psmithul/tensegrity-rover/bom/CY06_Rover_BOM.pdf

CY06 rover bill of materials | 25 October 2026
Supplied BOM total: INR 44,069.06 | 43 procurement lines
ID | Part and specification | Qty | Unit | Unit INR | Line INR | Basis | Supplier
1 | Wheel drive motor Johnson 12 V, 300 rpm | 4 | each | 583.00 | 2,332.00 | Listed | robu.in (https://robu.in/product/grade-a-quality-orange-12v-300-rpm-johnson-geared-dc-motor/)
2 | Servo | 6 | 1,409.00 | 8,454.00 | robu.in (https://robu.in/product/pro-range-ds3225-25kgcm-metal-gear-digital-servo-motor-180-degree/)
3 | Servo motor driver | 6 | 249.00 | 1,494.00 | robu.in (https://robu.in/product/16-channel-12-bit-pwmservo-driver-i2c-interface-pca9685-arduino-raspberry-pi/)
4 | Motor driver
BTS7960 H-bridge, KSTM1859
4 | each | 329.00 | 1,316.00 | Listed | robu.in (https://robu.in/product/double-bts7960-43a-h-bridge-high-power-stepper-motor-driver-module/)
5 | Wheel controller
Raspberry Pi Pico, RP2040
1 | each | 384.00 | 384.00 | Listed | Robu (https://robu.in/product/raspberry-pi-pico/)
6 | Logger and preload controller
Teensy
1 | each | 2,785.00 | 2,785.00 | Listed | robocraze.com (https://robocraze.com/products/teensy-4-0-development-board?variant=42205078192352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)
7 | Vibration accelerometer
ADXL345 module, RDNA-C50
3 | each | 255.00 | 765.00 | Listed | robocraze.com (https://robocraze.com/products/adxl345-digital-angle-acceleration-sensor-module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)
8 | Chassis attitude sensor
MPU6050 module, RDNA-E529
1 | each | 173.00 | 173.00 | Listed | robokits.co.in (https://robokits.co.in/sensors/accelerometer-and-magnetometer/triple-axis-accelerometer-gyro-mpu-6050-breakout)
9 | Encoder circuit set
Comparators, circuit boards and small components
1 | set | 300.00 | 300.00 | Estimate | Not specified
10 | Control signal buffer
74HCT245, 3.3 V to 5 V interface
4 | each | 149.00 | 596.00 | Listed | robu.in (https://robu.in/product/sn74hct245n-texas-instruments-transceiver-74hct245-4-5-v-to-5-5-v-dip-20/)
11 | Digital I/O expander
MCP23017 modules, addresses 0x20 and 0x21
2 | each | 332.00 | 664.00 | Listed | FlyRobo (https://www.flyrobo.in/mcu-2317-mcp23017-expander-serial-i2c-interface-module)
12 | Analog multiplexer
CD74HC4067 module, 16 channels
2 | each | 50.00 | 100.00 | Listed | robu.in (https://robu.in/product/cd74hc4067-high-speed-%25e2%2580%258b%25e2%2580%258bcmos-16-channel-analogdigital-multiplexer-breakout-module/)
13 | Input conditioning circuit set
Thirty ADC inputs, startup pull-downs and interface components
1 | set | 400.00 | 400.00 | Estimate | Not specified
INR. Rates and quantities as supplied. | 1 / 3

Supplied BOM total: INR 44,069.06 | 43 procurement lines
ID | Part and specification | Qty | Unit | Unit INR | Line INR | Basis | Supplier
14 | Preload position sensor Linear Hall sensor module | 6 | each | 40.00 | 240.00 | Listed | robu.in (https://robu.in/product/lm393-linear-hall-effect-sensor-module/)
15 | Preload travel limit switches
KW11 normally closed switches, pack of two
6 | pack | 29.00 | 174.00 | Listed | Robu (https://robu.in/product-category/limit-switch/)
16 | Memory card interface
SPI microSD reader module
1 | each | 40.00 | 40.00 | Listed | FlyRobo (https://www.flyrobo.in/tf-wifi-micro-sd-card-reader-module-for-d1-mini)
17 | Logging memory card
16 GB Class 10 microSD card
1 | each | 499.00 | 499.00 | Listed | HUBTRONICS (https://hubtronics.in/16gb-micro-sd-card)
18 | Battery
Li-Po
2 | each | 1,700.00 | 3,400.00 | Listed | robu.in (https://robu.in/product/orange-11-1v-2500mah-3c-3s-tx-lithium-polymer-battery-pack-with-jst-bec-connector/)
19 | Battery charger
13.8 V, 1.5 A VRLA float charger
1 | each | 249.00 | 249.00 | Listed | MakerBazar (https://makerbazar.in/products/12v-7ah-9ah-lead-acid-battery-charger12v-7ah-9ah-lead-acid-battery-charger)
20 | Motor supply relay
EF40-1A-12V power relay
1 | each | 76.70 | 76.70 | Listed | Rajiv Electronics (https://rajivelectronics.com/product/ef40-1a-12v-automotive-4-pin-40a-12vdc-relay-automotive-power-relay)
21 | Relay connection set
Socket, coil suppression and terminals
1 | set | 70.00 | 70.00 | Estimate | Rajiv Electronics / local assembly (https://rajivelectronics.com/product/ef40-1a-12v-automotive-4-pin-40a-12vdc-relay-automotive-power-relay)
22 | Emergency stop switch
Latching normally closed switch
1 | each | 109.00 | 109.00 | Listed | robu.in (https://robu.in/product/ac-660v-10a-lay37-dpst-emergency-stop-push-button-switch/)
23 | Ring Magnet
K800
1 | each | 29.00 | 29.00 | Listed | robu.in (https://robu.in/product/k800-round-super-circular-magnet/)
24 | Logic power regulator
5 V DC/DC converter
1 | each | 93.00 | 93.00 | Listed | FlyRobo (https://www.flyrobo.in/xl4015-5a-dc-dc-adjustable-step-down-power-supply-module-1)
25 | Sensor power regulator set
3.3 V regulator and decoupling components
1 | set | 50.00 | 50.00 | Estimate | Not specified
26 | Observation camera
ESP32-CAM module
1 | each | 750.00 | 750.00 | Listed | robocraze.com (https://robocraze.com/products/esp32s-cam-wifi-development-board-with-rhyx-m21-45-camera-module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)
27 | Power harness set
Power cable and locking connectors for twelve motor channels
1 | set | 900.00 | 900.00 | Estimate | Robu / local assembly (https://robu.in/product/14awg-silicone-braided-wire-black/)
28 | Signal harness set
Sensor wiring, connectors and integration PCB
1 | set | 700.00 | 700.00 | Estimate | ProBots / local assembly (https://probots.co.in/4-pin-jst-xh-polarised-connector-254mm-wire-harness.html)

Supplied BOM total: INR 44,069.06 | 43 procurement lines
ID | Part and specification | Qty | Unit | Unit INR | Line INR | Basis | Supplier
29 | Lock position switches Normally closed switches, pack of two
3 | pack | 29.00 | 87.00 | Listed | Robu (https://robu.in/product-category/limit-switch/)
30 | Battery energy measurement kit
INA219, external shunt and Kelvin connections
1 | set | 139.00 | 139.00 | Mixed | robu.in (https://robu.in/product/cjmcu-219-ina219-i2c-interface-no-drift-bi-directional-current-power-monitoring-sensor-module/)
31 | Rotary Encoder | 1 | set | 500.00 | 500.00 | robu.in (https://robu.in/product/oe-28-hall-effect-two-channel-magnetic-encoder/)
32 | Aluminium sheet and plate 600 x 600 x 2 mm; 600 x 600 x 4 mm; 200 x 200 x 12 mm
1 | lot | 3,304.00 | 3,304.00 | Estimate | Rajesh Aluminium
| | | | | | India (https://www.rajeshaluminium.com/gujarat)
33 | Aluminium hub bar Diameter 40 mm, length 300 mm
1 | length | 708.00 | 708.00 | Estimate | Rajesh Aluminium
| | | | | | India (https://www.rajeshaluminium.com/gujarat)
34 | Steel and brass stock Shaft rods, sleeve tube and brass nut blanks
1 | lot | 1,534.00 | 1,534.00 | Estimate | Rajesh Aluminium /
| | | | | | local Indian metal stockist (https://www.rajeshaluminium.com/gujarat)
35 | Steel lock and bracket blanks 40 x 20 x 2 mm rectangular tube, 450 mm long
2 | length | 206.50 | 413.00 | Estimate | Manish Steel Center
| | | | | | India (https://www.manishsteels.com/rectangle-pipes.php)
36 | Polymer stock PTFE tube, acetal offcuts and 1.5 mm roof sheet
1 | lot | 1,062.00 | 1,062.00 | Estimate | Robu / polymer
| | | | | | stockist (https://robu.in/product/ptfe-2x4mm-teflon-tubing-for-3d-printers-1-75mm-filament-1m/)
37 | PETG filament 1 kg spool, 1.75 mm diameter
3 | spool | 798.86 | 2,396.58 | Listed | Dream Polymers India (https://dreampolymers.com/product/petg-pro-3d-printing-filament/)
38 | TPU 95A filament
1 kg spool, 1.75 mm diameter
1 | spool | 1,414.82 | 1,414.82 | Listed | 3D Master India (https://3dmasterindia.in/product/isanmate-tpu-flexible-filament-black/)
39 | Tension cable and fittings
Stainless cable, swage sleeves and termination stock
1 | lot | 944.00 | 944.00 | Estimate | EBMP India (https://www.ebmpindia.com/steel-wire-ropes.html)
40 | Radial bearing
NBC 6001ZZ, 12 x 28 x 8 mm
24 | each | 21.00 | 504.00 | Listed | omrook.com (https://omrook.com/6001-2rs-deep-groove-ball-bearing-12x28x8/)
41 | Preload thrust bearing
NTN 51100, 10 x 24 x 9 mm
6 | each | 102.66 | 615.96 | Listed | omrook.com (https://omrook.com/51100-thrust-ball-bearing-id-10mm-od-24mm-th-9mm/)
42 | Fasteners and inserts
Bulk M2-M6 screws, nuts, inserts and retaining fittings
1 | lot | 2,832.00 | 2,832.00 | Estimate | Local fastener stockist (https://in.misumi-ec.com/vona2/detail/221000551286/)
43 | Assembly consumables
Rigid epoxy, protective pads, lubricant and cleaner
1 | lot | 472.00 | 472.00 | Mixed | Joy Guru Hardware (https://www.joyguruhardware.com/product/32365749/Araldite-Epoxy-Adhesive-90-gm)
