psmithul/tensegrity-rover/models/Print_Blanks/Fixed_Star_Plate_Print_Blank_Left.step

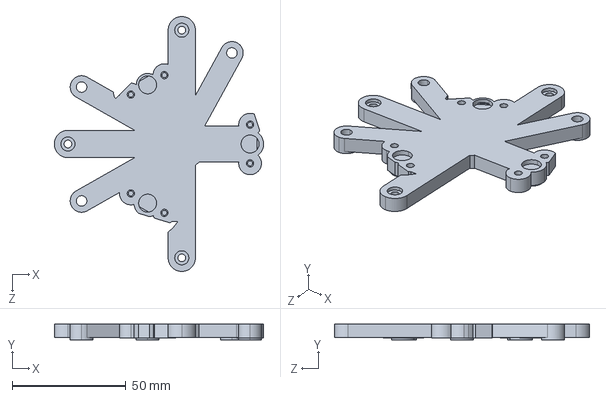
[picture p17: CAD file, 2026-11-02]
models/Print_Blanks/Fixed_Star_Plate_Print_Blank_Left.step
92.0 x 7.00 x 112.0 mm
