psmithul/tensegrity-rover/models/SolidWorks/References/Joint_Preload_Hardware_References.SLDPRT

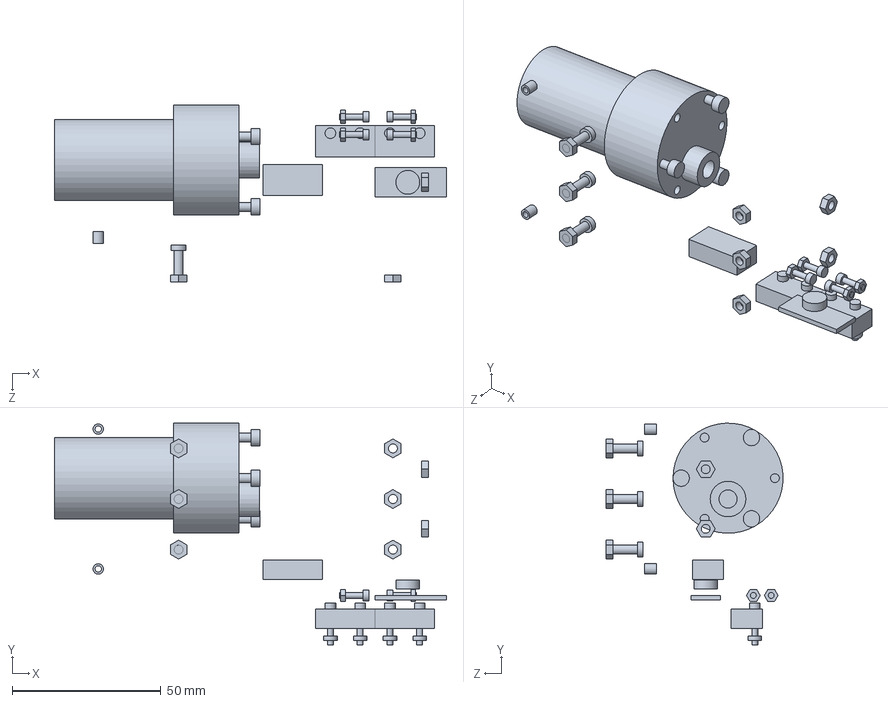
[picture p18: CAD file, 2026-11-02]
models/SolidWorks/References/Joint_Preload_Hardware_References.SLDPRT
131.7 x 74.5 x 59.5 mm
