psmithul/tensegrity-rover/models/STEP/Fixed_Frame.step

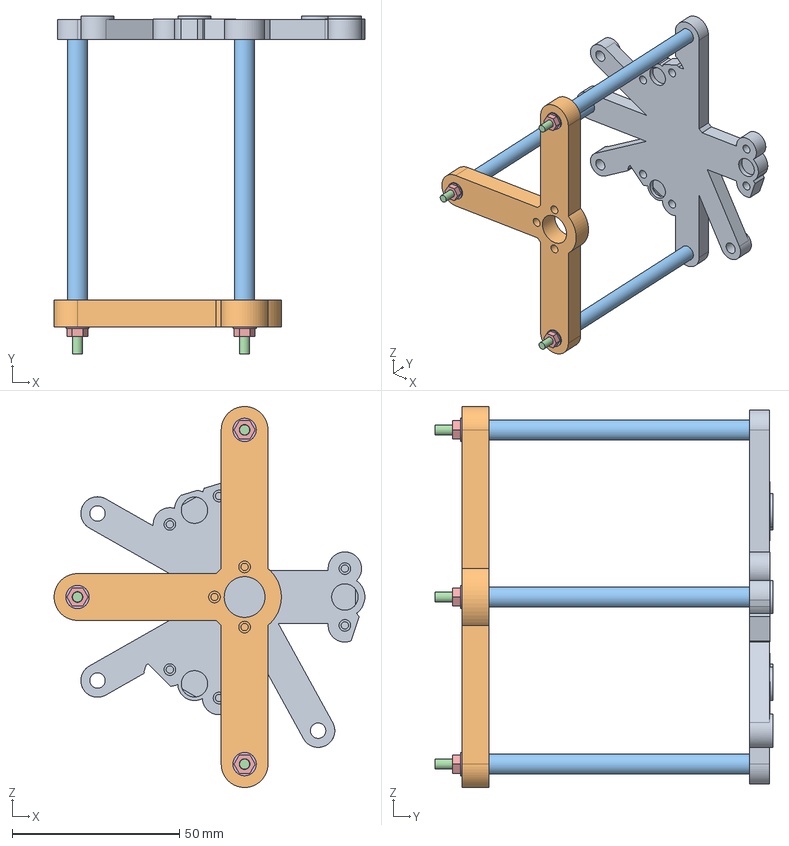
[picture p19: CAD file, 2026-11-02]
models/STEP/Fixed_Frame.step
93.0 x 101.1 x 114.0 mm
