psmithul/tensegrity-rover/models/STEP/Parts/Preload_Guide_Rod_End_Stop.step

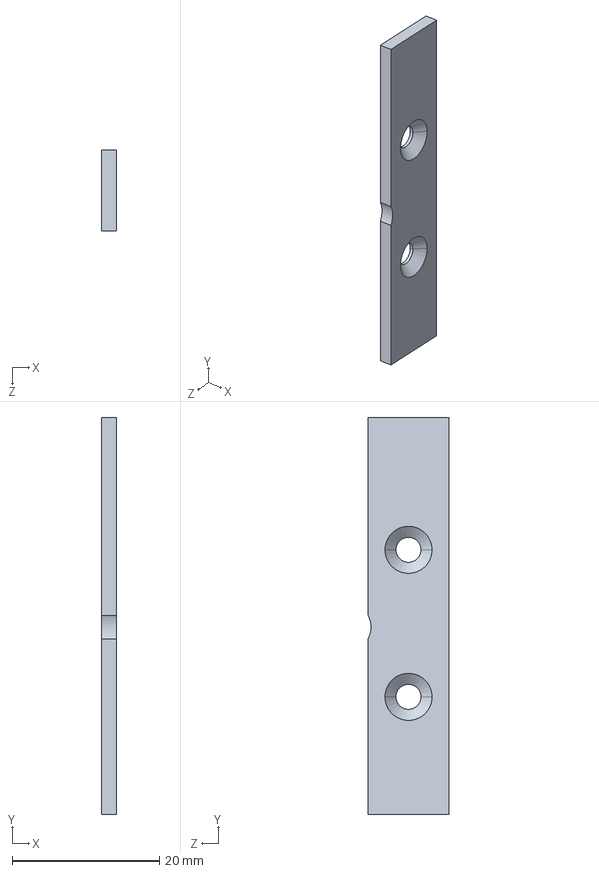
[picture p20: CAD file, 2026-11-02]
models/STEP/Parts/Preload_Guide_Rod_End_Stop.step
2.00 x 54.0 x 11.0 mm
