psmithul/tensegrity-rover/models/STEP/Purchased_Components/Rover_Vibration_Sensors_References.step

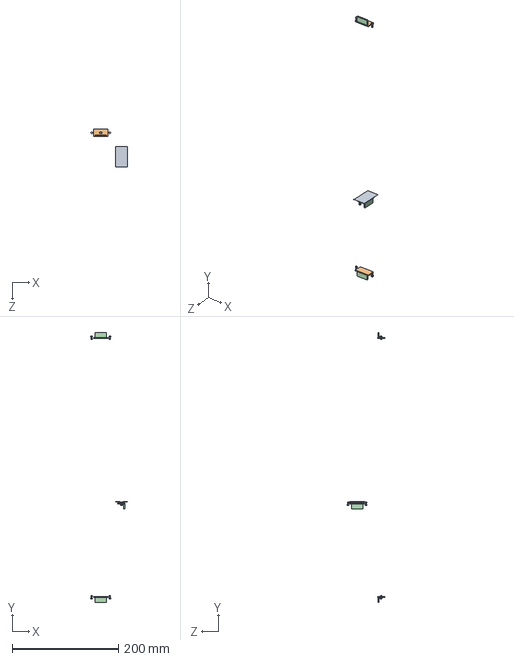
[picture p21: CAD file, 2026-11-02]
models/STEP/Purchased_Components/Rover_Vibration_Sensors_References.step
68.9 x 508.0 x 71.2 mm
