psmithul/tensegrity-rover/models/Print_Blanks/Rear_Support_Plate_Print_Blank.step

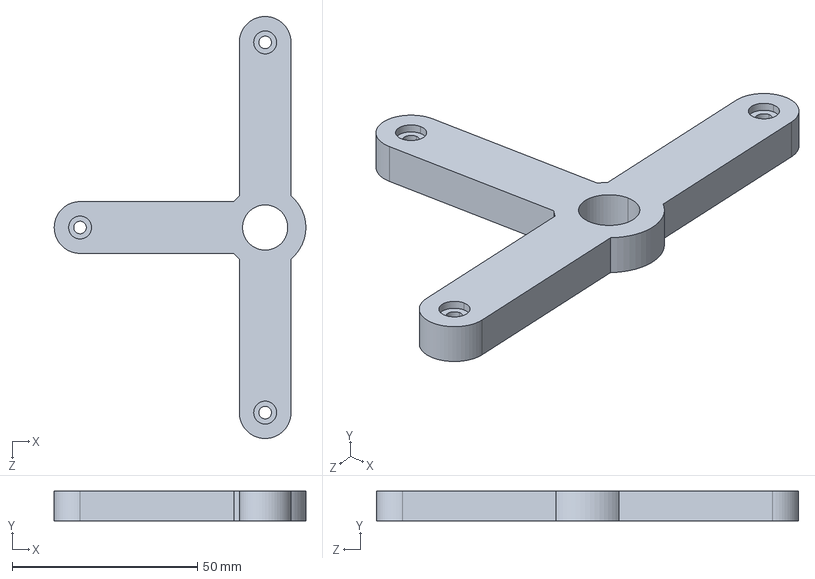
[picture p22: CAD file, 2026-11-02]
models/Print_Blanks/Rear_Support_Plate_Print_Blank.step
68.0 x 8.00 x 114.0 mm
