psmithul/tensegrity-rover/models/STEP/Parts/Suspension_Compression_Link_3_Moving_Ball_Retainer_Left.step

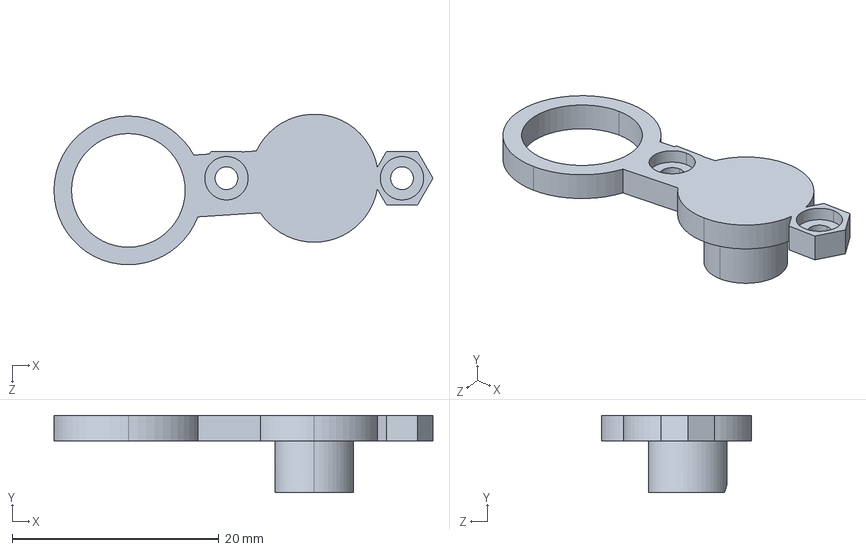
[picture p23: CAD file, 2026-11-02]
models/STEP/Parts/Suspension_Compression_Link_3_Moving_Ball_Retainer_Left.step
36.7 x 7.50 x 14.6 mm
