psmithul/tensegrity-rover/models/STEP/Purchased_Components/Rover_Rear_Left_Suspension_References.step

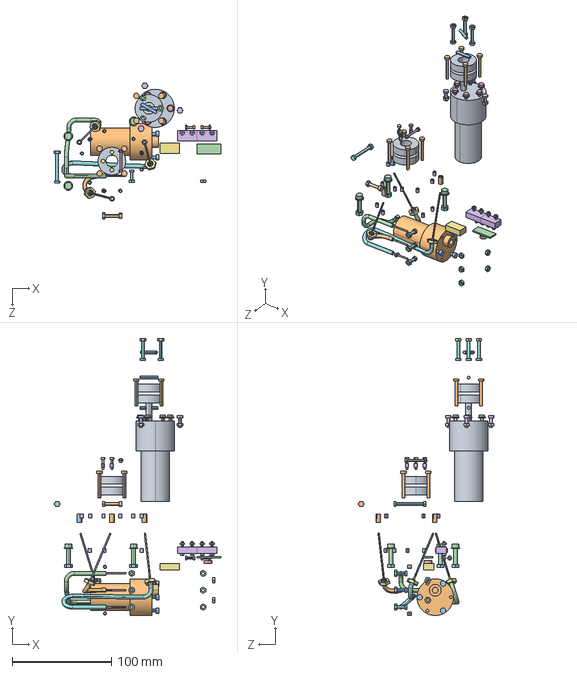
[picture p24: CAD file, 2026-11-02]
models/STEP/Purchased_Components/Rover_Rear_Left_Suspension_References.step
168.4 x 279.5 x 137.1 mm
