psmithul/tensegrity-rover/models/STEP/Parts/Suspension_Fixed_Steel_Cup_Liner_2.step

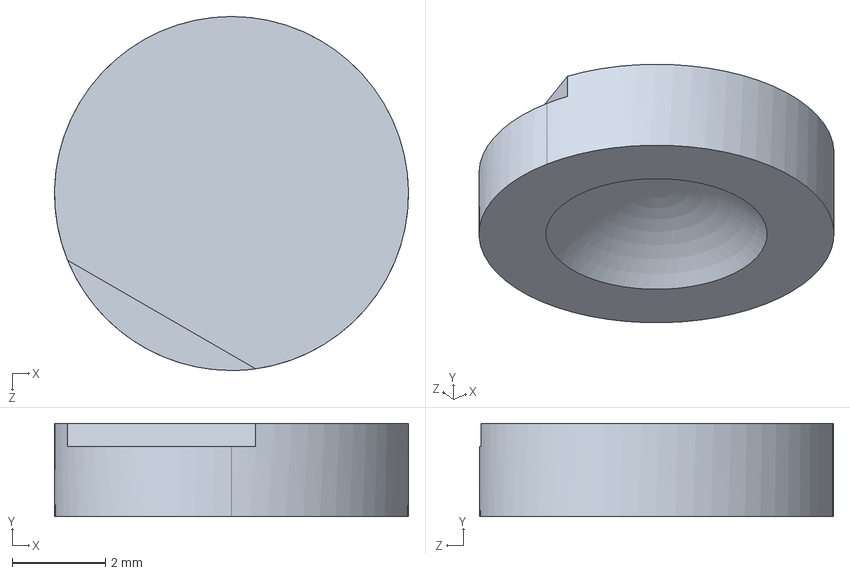
[picture p25: CAD file, 2026-11-02]
models/STEP/Parts/Suspension_Fixed_Steel_Cup_Liner_2.step
7.60 x 2.00 x 7.60 mm
