psmithul/tensegrity-rover/models/STEP/Purchased_Components/Rover_Middle_Right_Suspension_References.step

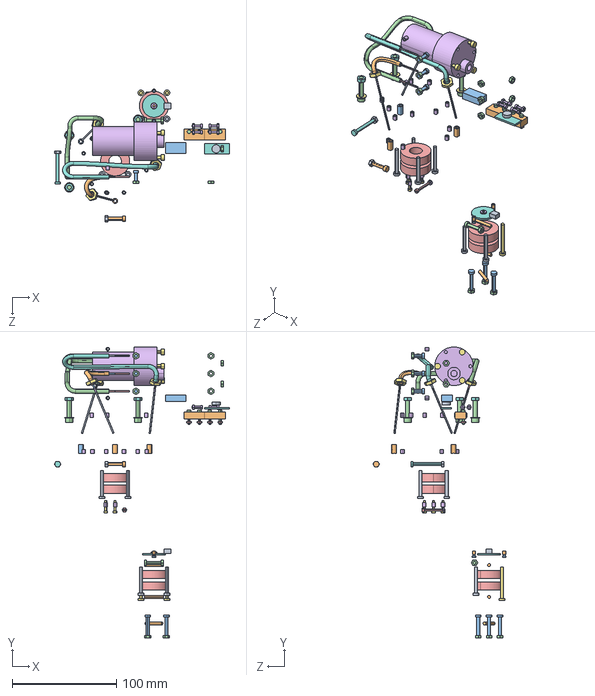
[picture p26: CAD file, 2026-11-02]
models/STEP/Purchased_Components/Rover_Middle_Right_Suspension_References.step
168.4 x 279.5 x 127.9 mm
