psmithul/tensegrity-rover/models/SolidWorks/References/Joint_Sensor_References.SLDPRT

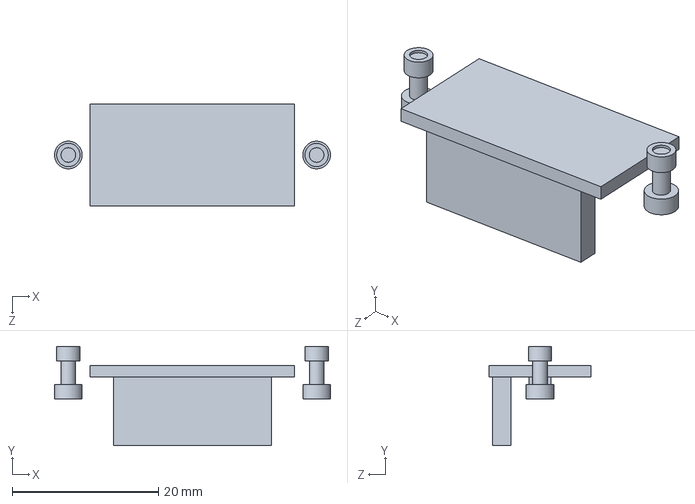
[picture p27: CAD file, 2026-11-02]
models/SolidWorks/References/Joint_Sensor_References.SLDPRT
37.8 x 13.6 x 14.0 mm
