psmithul/tensegrity-rover/models/STEP/Parts/Suspension_Cable_End_Ball_Socket_Left.step

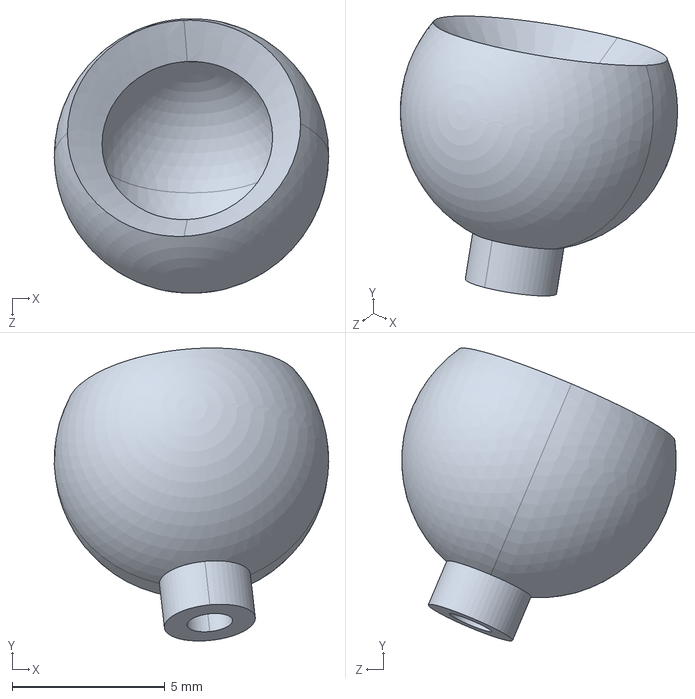
[picture p28: CAD file, 2026-11-02]
models/STEP/Parts/Suspension_Cable_End_Ball_Socket_Left.step
9.00 x 9.60 x 8.99 mm
