psmithul/tensegrity-rover/models/STEP/Purchased_Components/Joint_Joint_Hardware_References.step

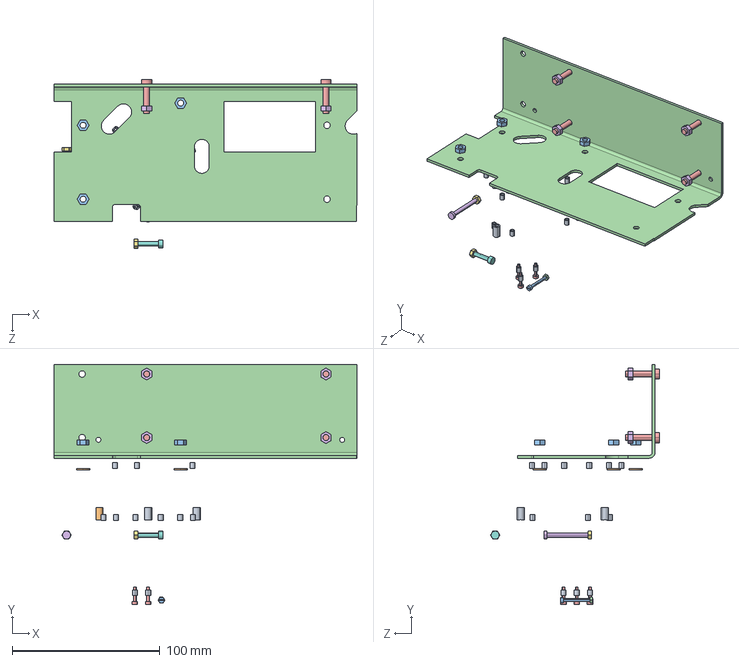
[picture p29: CAD file, 2026-11-02]
models/STEP/Purchased_Components/Joint_Joint_Hardware_References.step
205.0 x 162.5 x 114.4 mm
