psmithul/tensegrity-rover/models/SolidWorks/References/Joint_Wheel_and_Encoder_References.SLDPRT

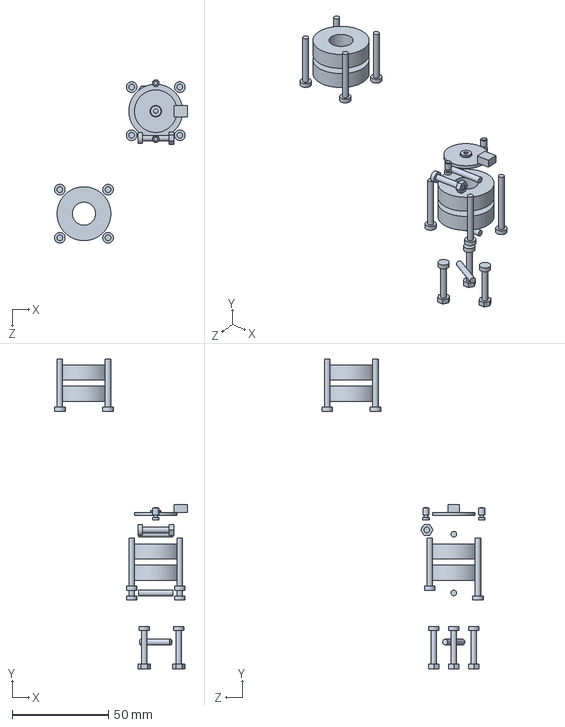
[picture p30: CAD file, 2026-11-02]
models/SolidWorks/References/Joint_Wheel_and_Encoder_References.SLDPRT
69.1 x 161.0 x 84.9 mm
