psmithul/tensegrity-rover/models/STEP/Parts/Suspension_Cable_Support_Mounting_Spacer.step

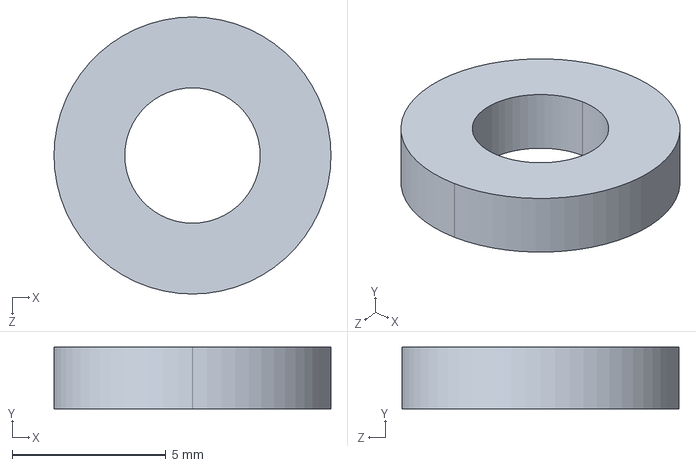
[picture p31: CAD file, 2026-11-02]
models/STEP/Parts/Suspension_Cable_Support_Mounting_Spacer.step
9.00 x 2.00 x 9.00 mm
