psmithul/tensegrity-rover/models/STEP/Parts/Compression_Link_Torque_Pin.step

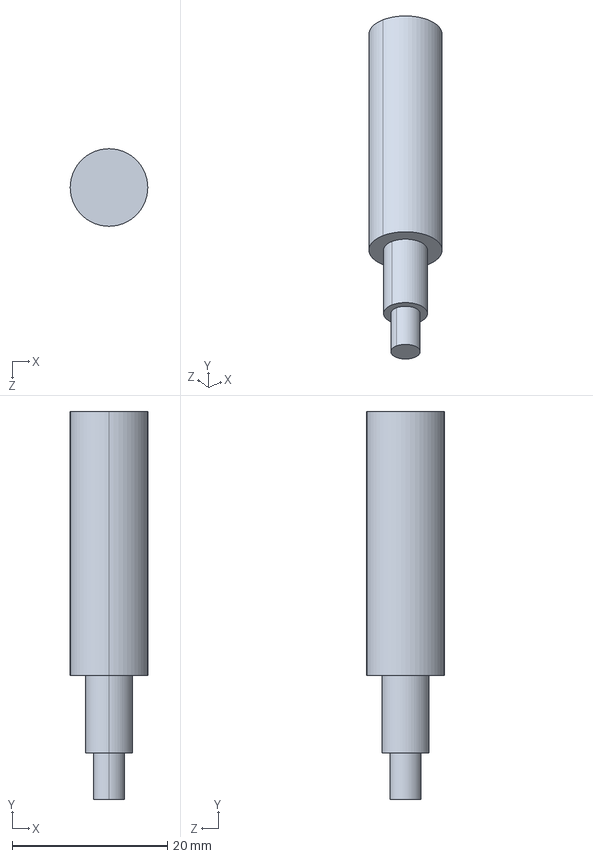
[picture p32: CAD file, 2026-11-02]
models/STEP/Parts/Compression_Link_Torque_Pin.step
10.0 x 50.0 x 10.0 mm
