psmithul/tensegrity-rover/models/STEP/Purchased_Components/Joint_Tension_Network_References.step

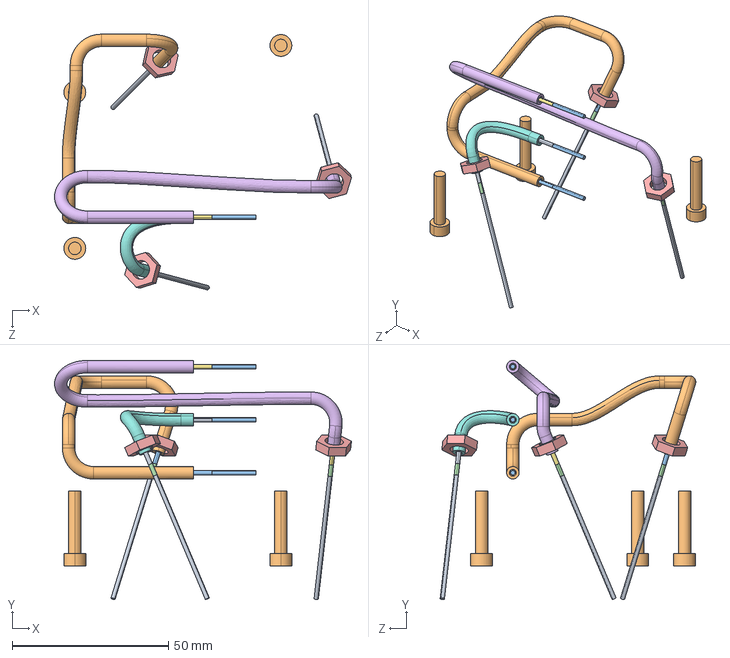
[picture p33: CAD file, 2026-11-02]
models/STEP/Purchased_Components/Joint_Tension_Network_References.step
95.1 x 76.6 x 81.9 mm
