psmithul/tensegrity-rover/models/STEP/Parts/Sensors_Chassis_Accelerometer_Mount.step

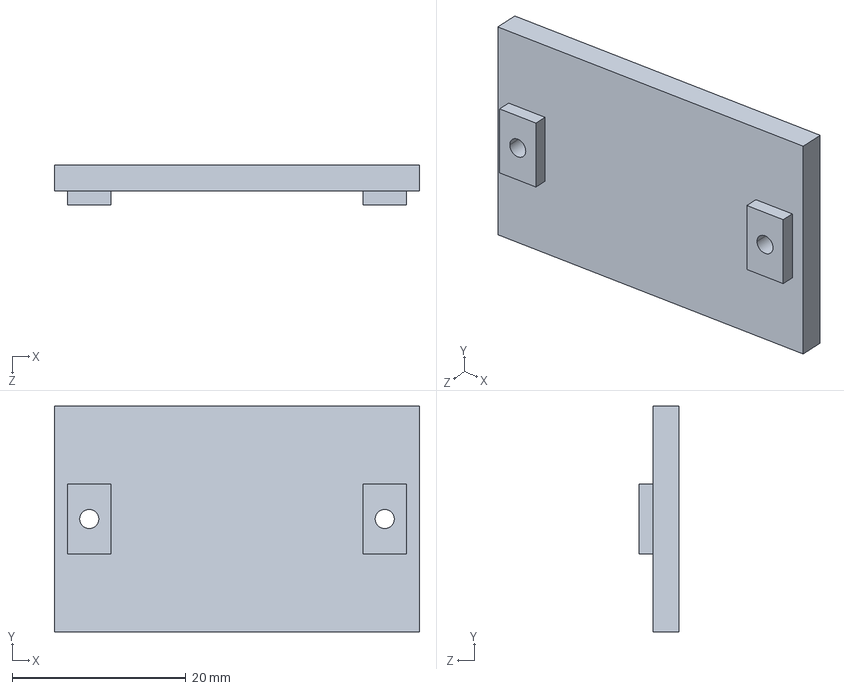
[picture p34: CAD file, 2026-11-02]
models/STEP/Parts/Sensors_Chassis_Accelerometer_Mount.step
42.0 x 26.0 x 4.60 mm
