psmithul/tensegrity-rover/models/SolidWorks/References/Rover_Chassis_and_Electronics_References.SLDPRT

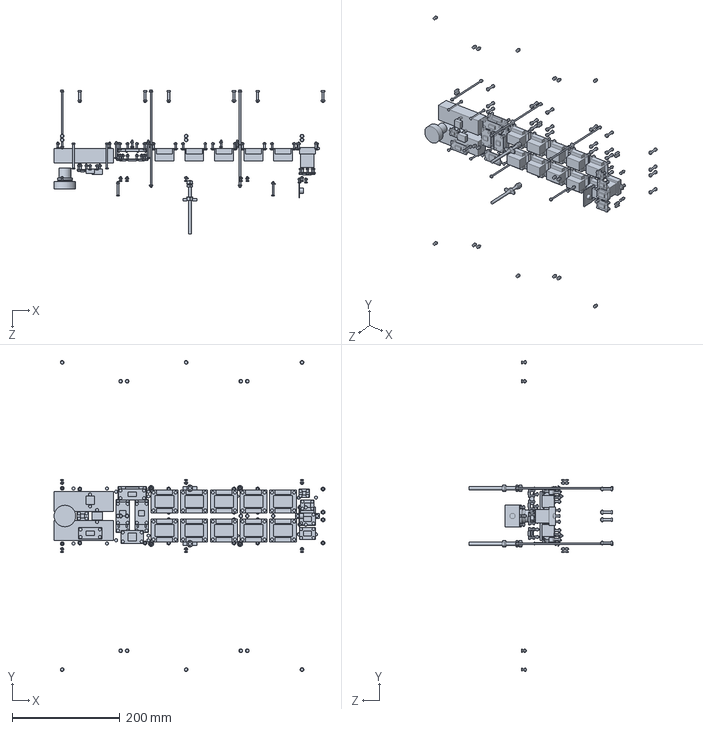
[picture p35: CAD file, 2026-11-02]
models/SolidWorks/References/Rover_Chassis_and_Electronics_References.SLDPRT
502.5 x 577.0 x 268.0 mm
