psmithul/tensegrity-rover/models/STEP/Parts/Chassis_Roof_Support_Arm_1_Right.step

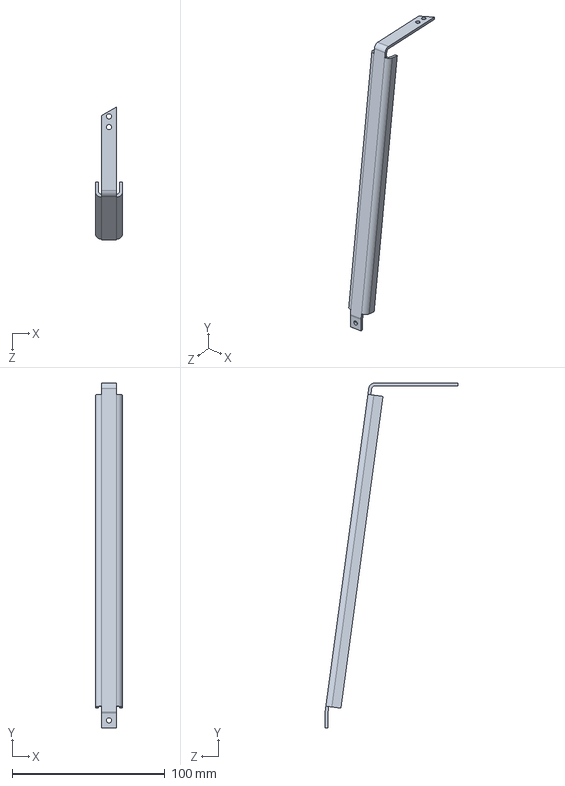
[picture p36: CAD file, 2026-11-02]
models/STEP/Parts/Chassis_Roof_Support_Arm_1_Right.step
18.0 x 226.0 x 87.2 mm
