psmithul/tensegrity-rover/models/SolidWorks/References/Rover_Middle_Left_Suspension_References.SLDPRT

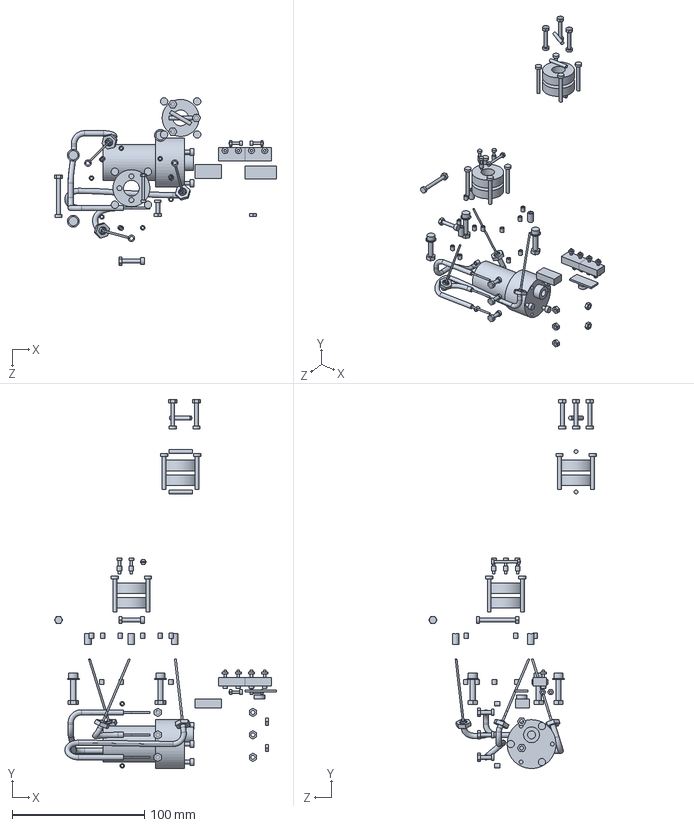
[picture p37: CAD file, 2026-11-02]
models/SolidWorks/References/Rover_Middle_Left_Suspension_References.SLDPRT
168.4 x 279.5 x 126.9 mm
