psmithul/tensegrity-rover/models/STEP/Parts/Drive_Bearing_Cartridge_Left.step

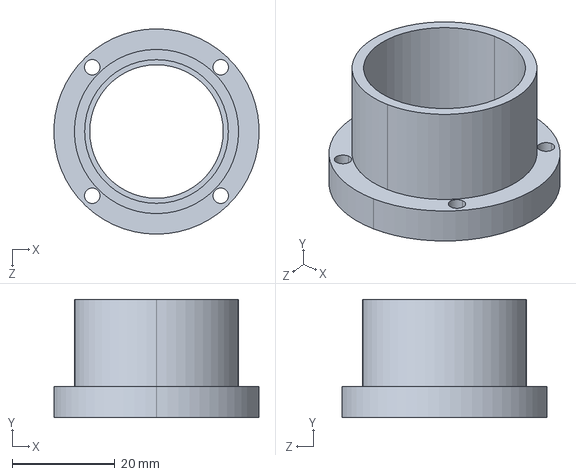
[picture p38: CAD file, 2026-11-02]
models/STEP/Parts/Drive_Bearing_Cartridge_Left.step
39.9 x 23.0 x 40.0 mm
