psmithul/tensegrity-rover/models/STEP/Purchased_Components/Joint_Preload_Hardware_References.step

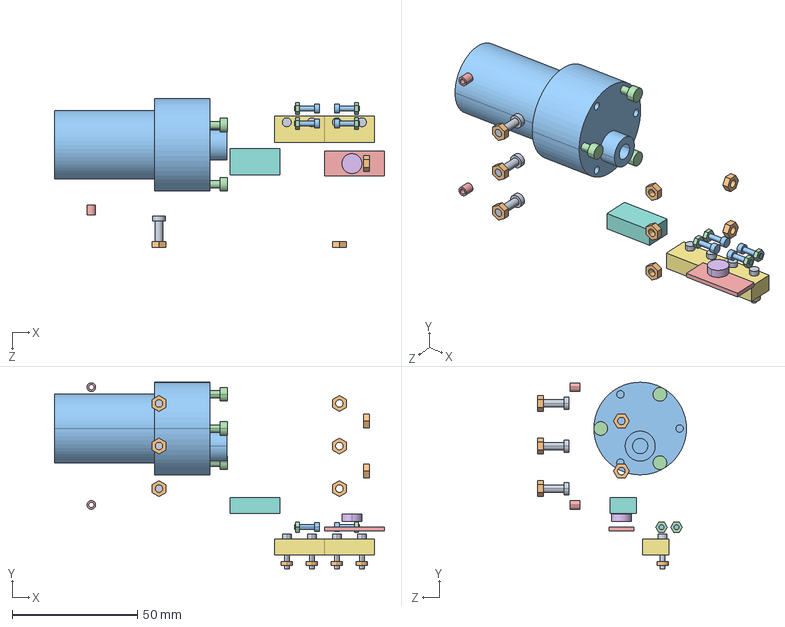
[picture p39: CAD file, 2026-11-02]
models/STEP/Purchased_Components/Joint_Preload_Hardware_References.step
131.7 x 74.5 x 59.5 mm
