psmithul/tensegrity-rover/models/STEP/Parts/Chassis_Platform_Joint_Strap_1_Right.step

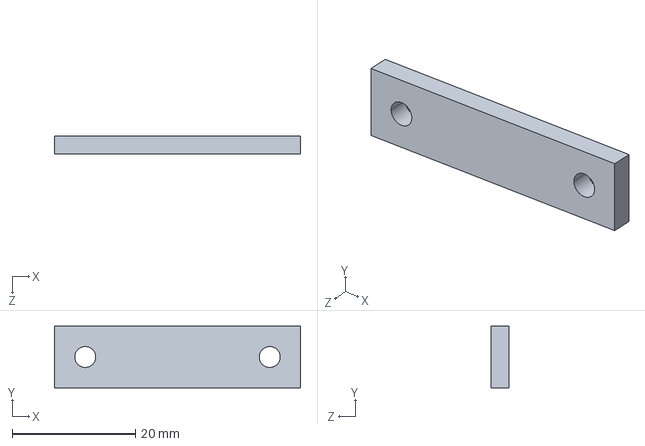
[picture p40: CAD file, 2026-11-02]
models/STEP/Parts/Chassis_Platform_Joint_Strap_1_Right.step
40.0 x 10.0 x 3.00 mm
