psmithul/tensegrity-rover/models/STEP/Parts/Suspension_Acetal_Torque_Guide_Bush_Relieved_Left.step

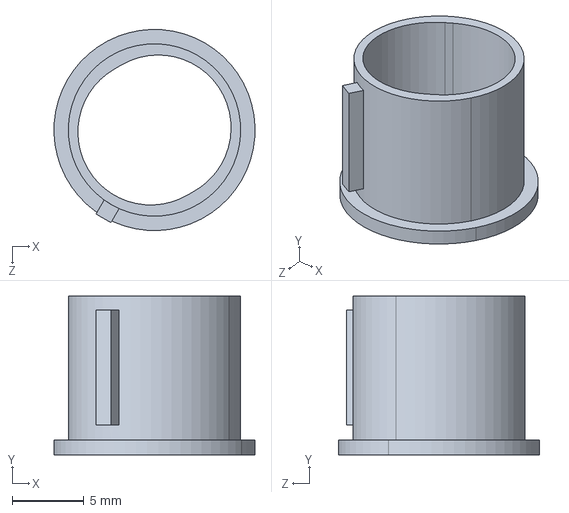
[picture p41: CAD file, 2026-11-02]
models/STEP/Parts/Suspension_Acetal_Torque_Guide_Bush_Relieved_Left.step
14.0 x 11.0 x 14.0 mm
