psmithul/tensegrity-rover/models/STEP/Parts/Chassis_Ballast_End_Stop_Rear.step

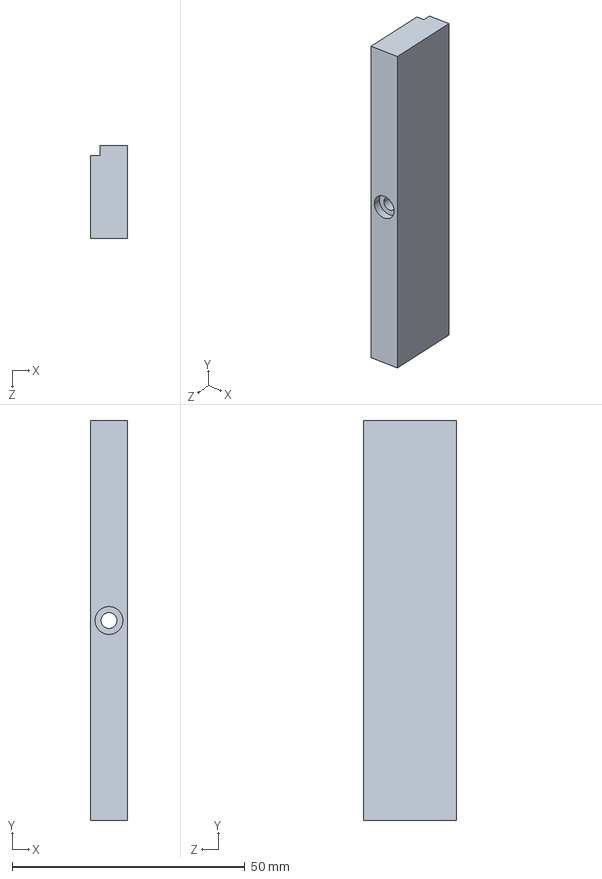
[picture p42: CAD file, 2026-11-02]
models/STEP/Parts/Chassis_Ballast_End_Stop_Rear.step
8.00 x 86.0 x 20.0 mm
