psmithul/tensegrity-rover/models/STEP/Parts/Suspension_Compression_Link_2_Moving_Ball_Retainer.step

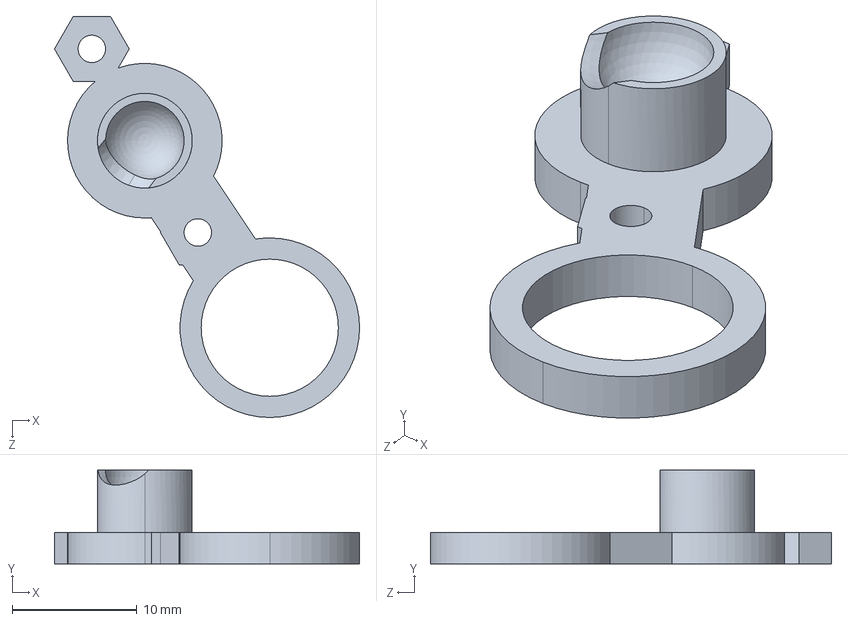
[picture p43: CAD file, 2026-11-02]
models/STEP/Parts/Suspension_Compression_Link_2_Moving_Ball_Retainer.step
24.5 x 7.50 x 32.2 mm
