psmithul/tensegrity-rover/models/STEP/Parts/Drive_Printed_Wheel_Rim_Left.step

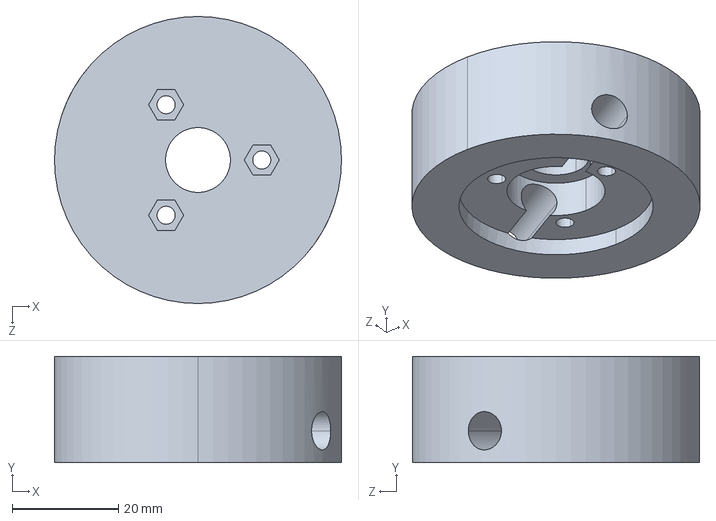
[picture p44: CAD file, 2026-11-02]
models/STEP/Parts/Drive_Printed_Wheel_Rim_Left.step
54.0 x 20.0 x 54.0 mm
