psmithul/tensegrity-rover/models/STEP/Parts/Suspension_Front_Cable_Clevis.step

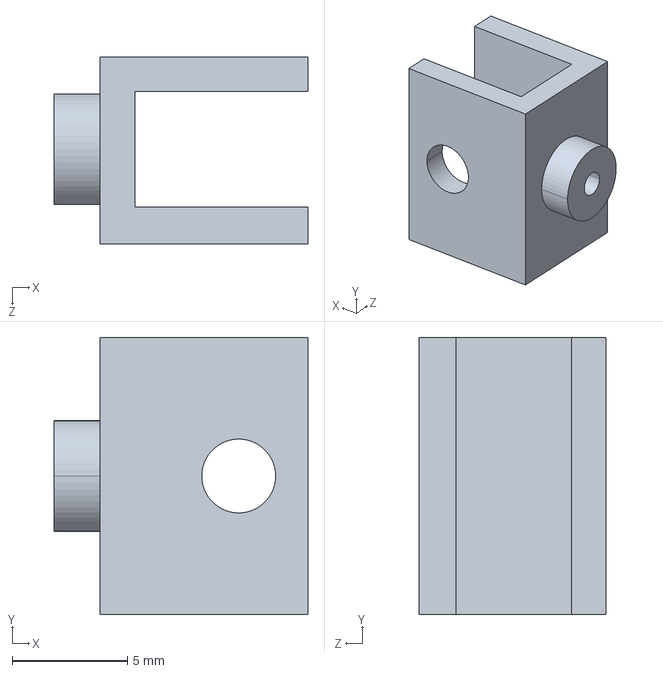
[picture p45: CAD file, 2026-11-02]
models/STEP/Parts/Suspension_Front_Cable_Clevis.step
11.0 x 12.0 x 8.10 mm
