psmithul/tensegrity-rover/models/STEP/Parts/Suspension_Cable_Anchor_Ball_Stud_Left.step

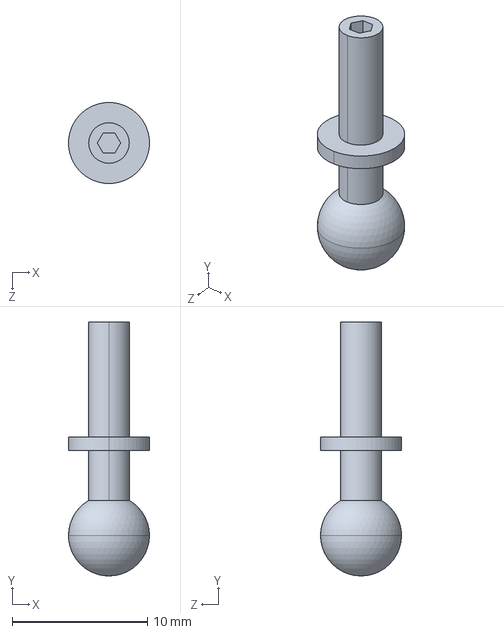
[picture p46: CAD file, 2026-11-02]
models/STEP/Parts/Suspension_Cable_Anchor_Ball_Stud_Left.step
6.00 x 18.8 x 6.00 mm
