psmithul/tensegrity-rover/models/STEP/Parts/Chassis_I2C_Interface_Shelf.step

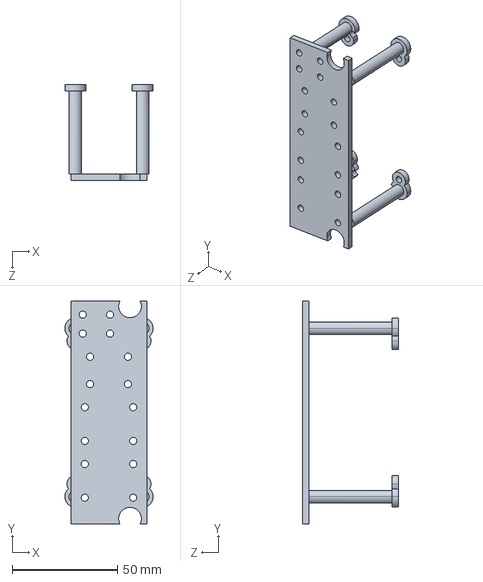
[picture p47: CAD file, 2026-11-02]
models/STEP/Parts/Chassis_I2C_Interface_Shelf.step
42.0 x 106.0 x 45.5 mm
