psmithul/tensegrity-rover/models/STEP/Parts/Suspension_Pivot_Shaft_Split_Clamp_Collar_Left.step

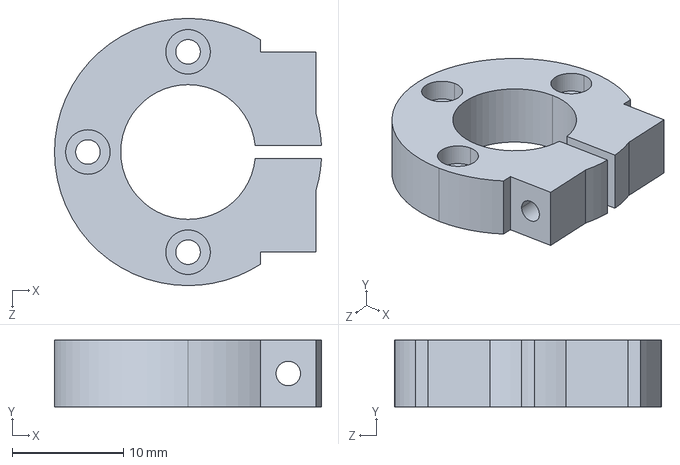
[picture p48: CAD file, 2026-11-02]
models/STEP/Parts/Suspension_Pivot_Shaft_Split_Clamp_Collar_Left.step
24.0 x 6.00 x 24.0 mm
