psmithul/tensegrity-rover/models/STEP/Parts/Preload_Elastomer_Spring_Installed_Envelope.step

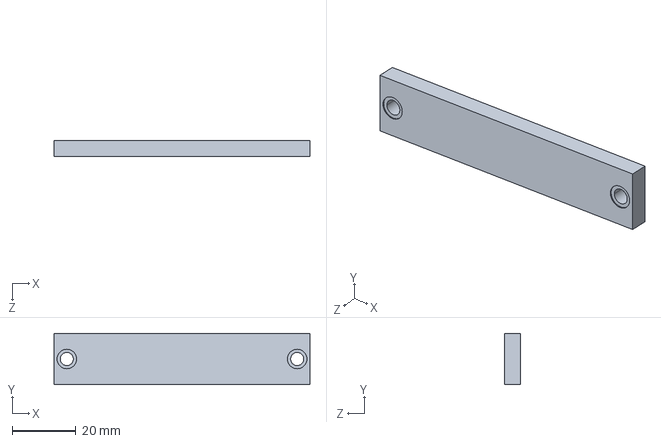
[picture p49: CAD file, 2026-11-02]
models/STEP/Parts/Preload_Elastomer_Spring_Installed_Envelope.step
80.0 x 16.0 x 5.00 mm
