psmithul/tensegrity-rover/models/STEP/Parts/Suspension_Compression_Outer_Sleeve_Left.step

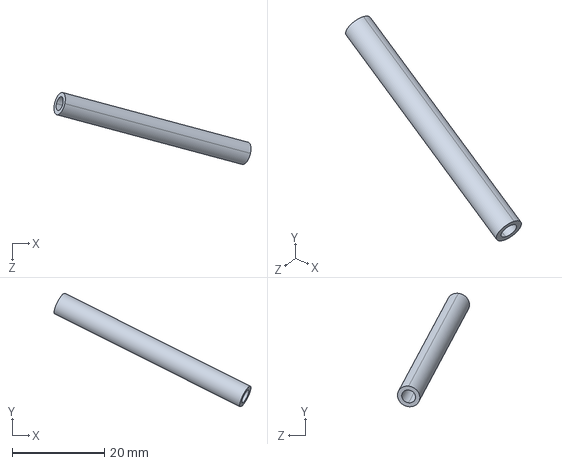
[picture p50: CAD file, 2026-11-02]
models/STEP/Parts/Suspension_Compression_Outer_Sleeve_Left.step
42.8 x 24.7 x 15.7 mm
