psmithul/tensegrity-rover/models/STEP/Parts/Drive_Passive_Wheel_Axle_Left.step

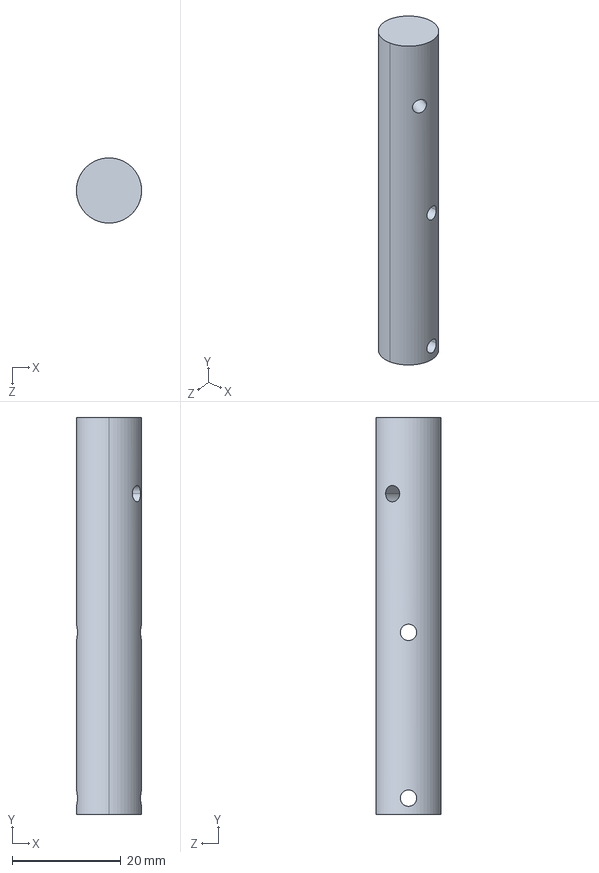
[picture p51: CAD file, 2026-11-02]
models/STEP/Parts/Drive_Passive_Wheel_Axle_Left.step
12.0 x 73.0 x 12.0 mm
