psmithul/tensegrity-rover/models/STEP/Parts/Moving_Tensegrity_Frame.step

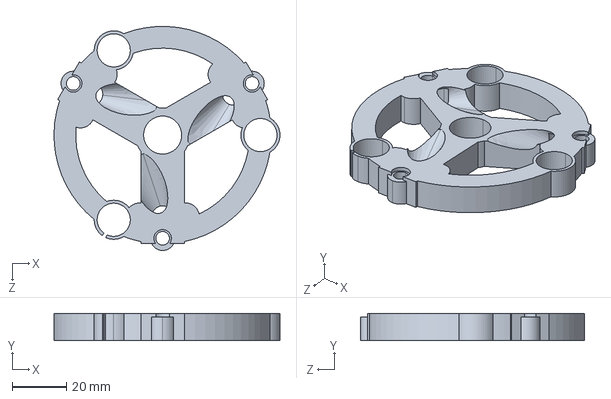
[picture p52: CAD file, 2026-11-02]
models/STEP/Parts/Moving_Tensegrity_Frame.step
83.2 x 10.0 x 82.5 mm
