psmithul/tensegrity-rover/models/STEP/Parts/Drive_Removable_Drive_Motor_Guard.step

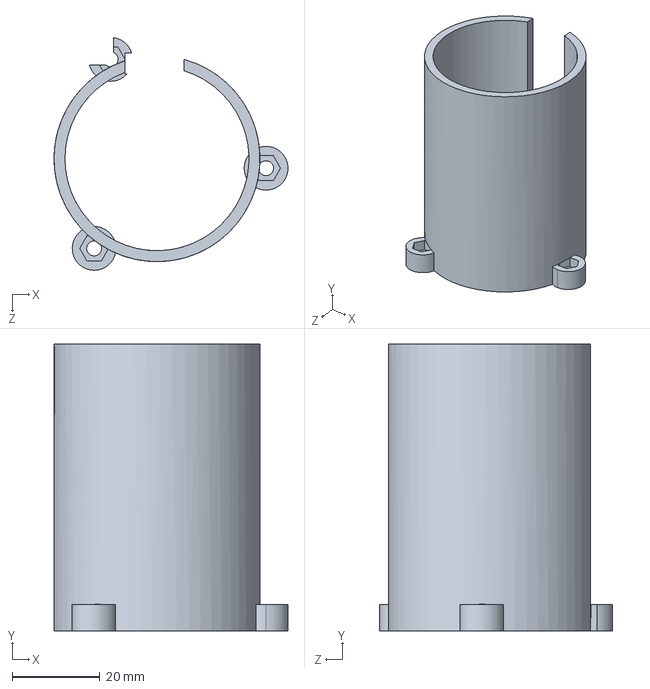
[picture p53: CAD file, 2026-11-02]
models/STEP/Parts/Drive_Removable_Drive_Motor_Guard.step
53.4 x 65.5 x 53.1 mm
