psmithul/tensegrity-rover/models/STEP/Parts/Drive_Metal_Wheel_Hub.step

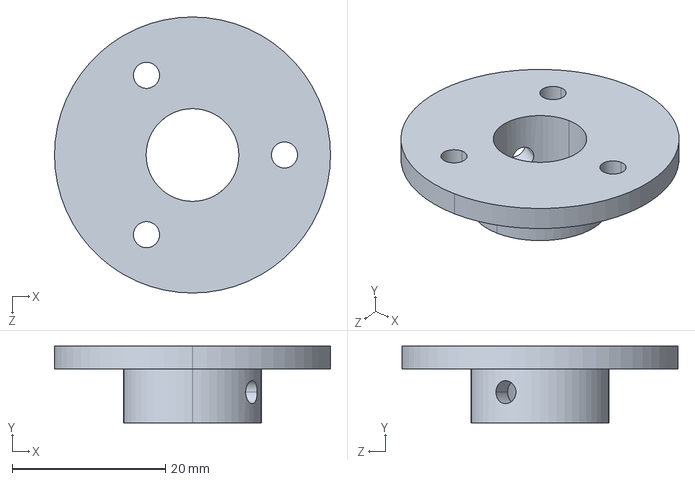
[picture p54: CAD file, 2026-11-02]
models/STEP/Parts/Drive_Metal_Wheel_Hub.step
36.0 x 10.0 x 36.0 mm
