psmithul/tensegrity-rover/models/STEP/Parts/Chassis_Power_Shelf_Post_1.step

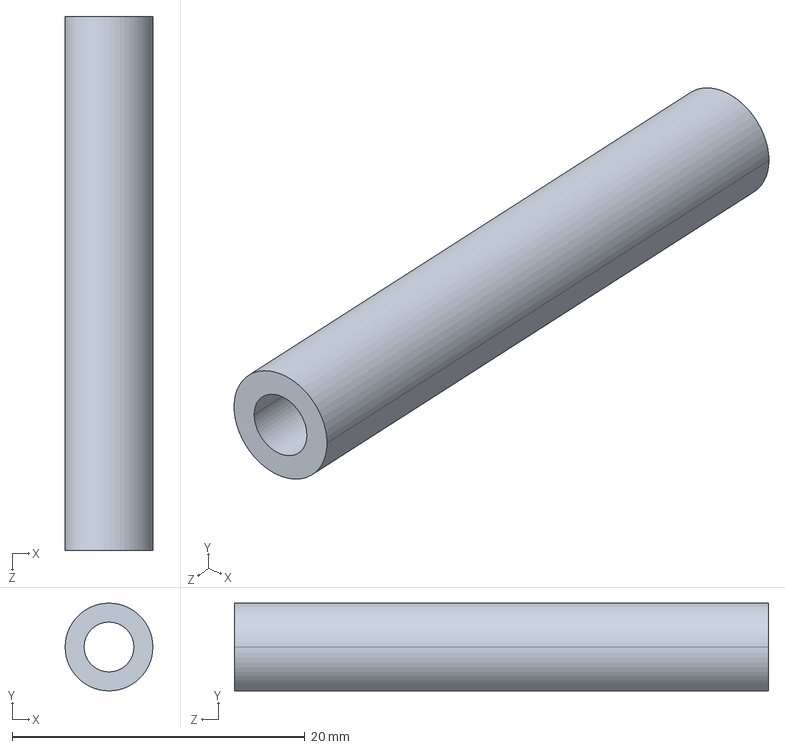
[picture p55: CAD file, 2026-11-02]
models/STEP/Parts/Chassis_Power_Shelf_Post_1.step
6.00 x 6.00 x 36.5 mm
