psmithul/tensegrity-rover/models/STEP/Parts/Preload_Steel_Carriage_Core.step

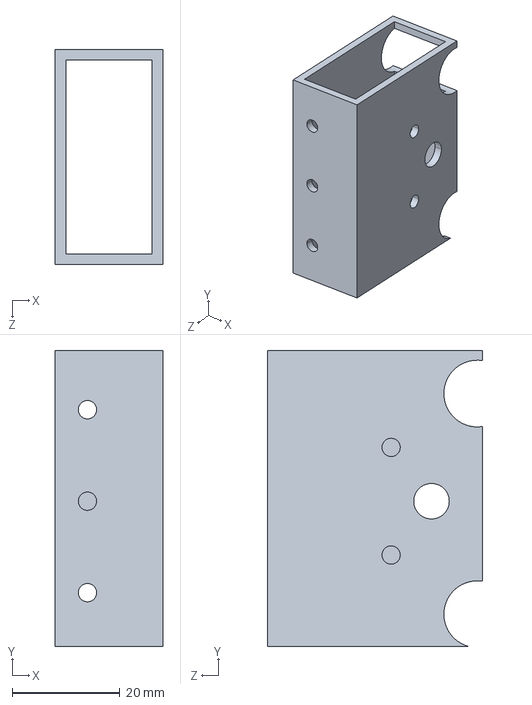
[picture p56: CAD file, 2026-11-02]
models/STEP/Parts/Preload_Steel_Carriage_Core.step
20.0 x 55.0 x 40.0 mm
