psmithul/tensegrity-rover/models/STEP/Parts/Chassis_Top_Cover_Joint_Strip_2.step

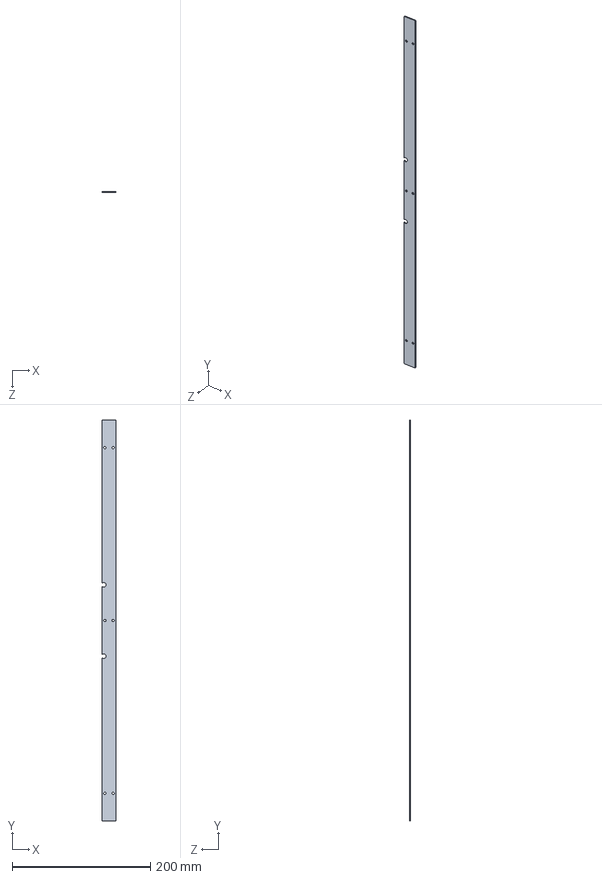
[picture p57: CAD file, 2026-11-02]
models/STEP/Parts/Chassis_Top_Cover_Joint_Strip_2.step
20.0 x 580.0 x 1.50 mm
