psmithul/tensegrity-rover/models/STEP/Parts/Preload_Manual_Lock_Pin_Left.step

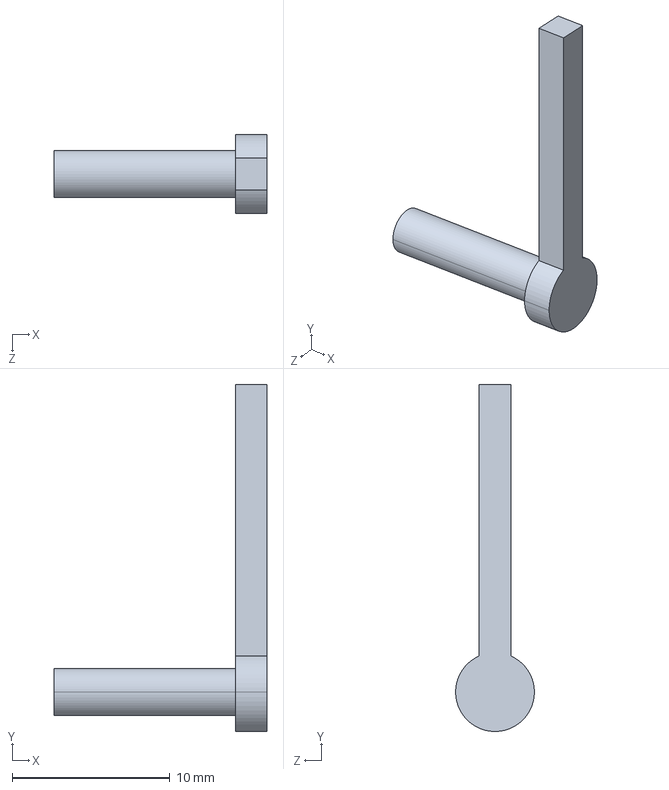
[picture p58: CAD file, 2026-11-02]
models/STEP/Parts/Preload_Manual_Lock_Pin_Left.step
13.5 x 22.0 x 5.00 mm
