psmithul/tensegrity-rover/models/STEP/Parts/Chassis_Ballast_Support_Tube_2_Left.step

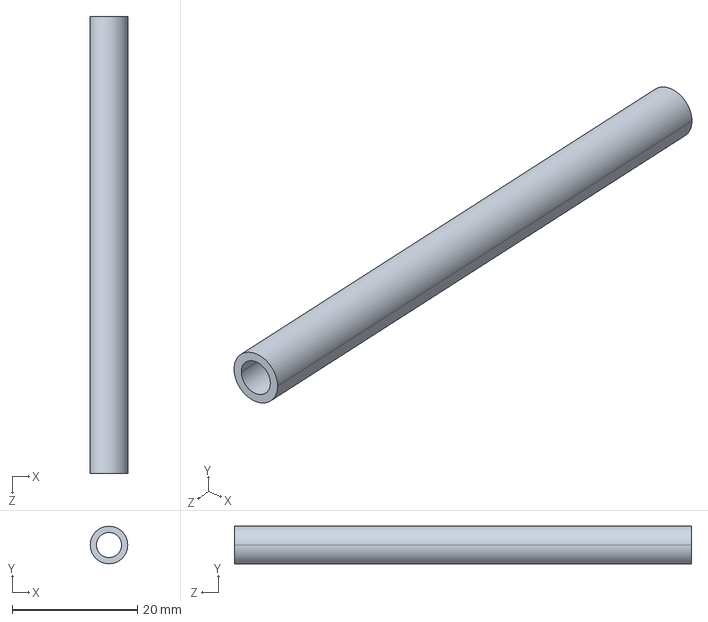
[picture p59: CAD file, 2026-11-02]
models/STEP/Parts/Chassis_Ballast_Support_Tube_2_Left.step
6.00 x 6.00 x 73.0 mm
