psmithul/tensegrity-rover/models/STEP/Parts/Suspension_Preload_Base_Mounting_Spacer.step

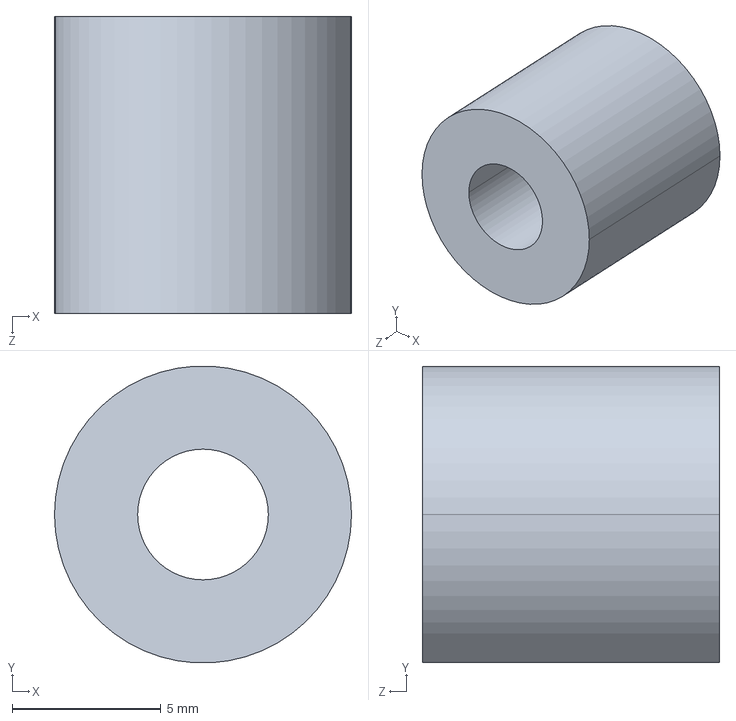
[picture p60: CAD file, 2026-11-02]
models/STEP/Parts/Suspension_Preload_Base_Mounting_Spacer.step
10.00 x 9.98 x 10.0 mm
