psmithul/tensegrity-rover/models/STEP/Parts/Suspension_Moving_Steel_Cup_Liner_2.step

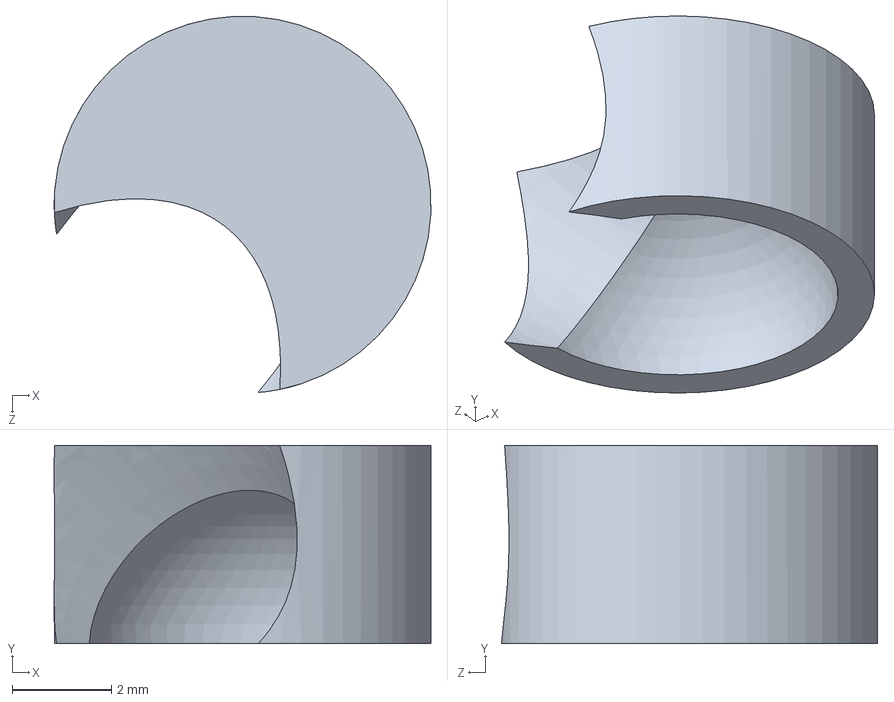
[picture p61: CAD file, 2026-11-02]
models/STEP/Parts/Suspension_Moving_Steel_Cup_Liner_2.step
7.59 x 4.00 x 7.58 mm
