psmithul/tensegrity-rover/models/STEP/Parts/Suspension_Compression_Inner_Strut_Lane2.step

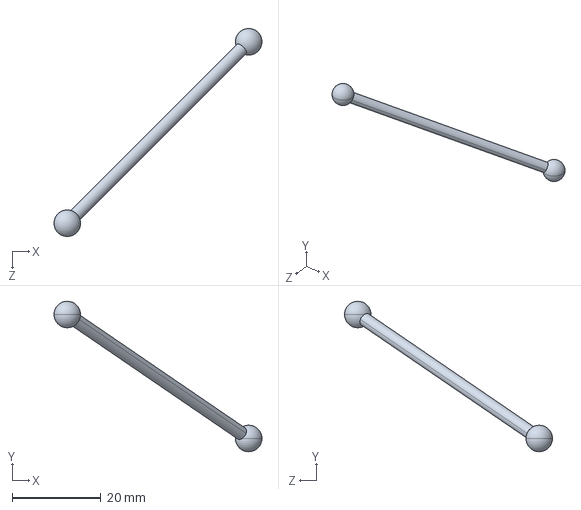
[picture p62: CAD file, 2026-11-02]
models/STEP/Parts/Suspension_Compression_Inner_Strut_Lane2.step
47.0 x 34.0 x 47.0 mm
