psmithul/tensegrity-rover/models/STEP/Parts/Preload_Rear_Spring_Spacer.step

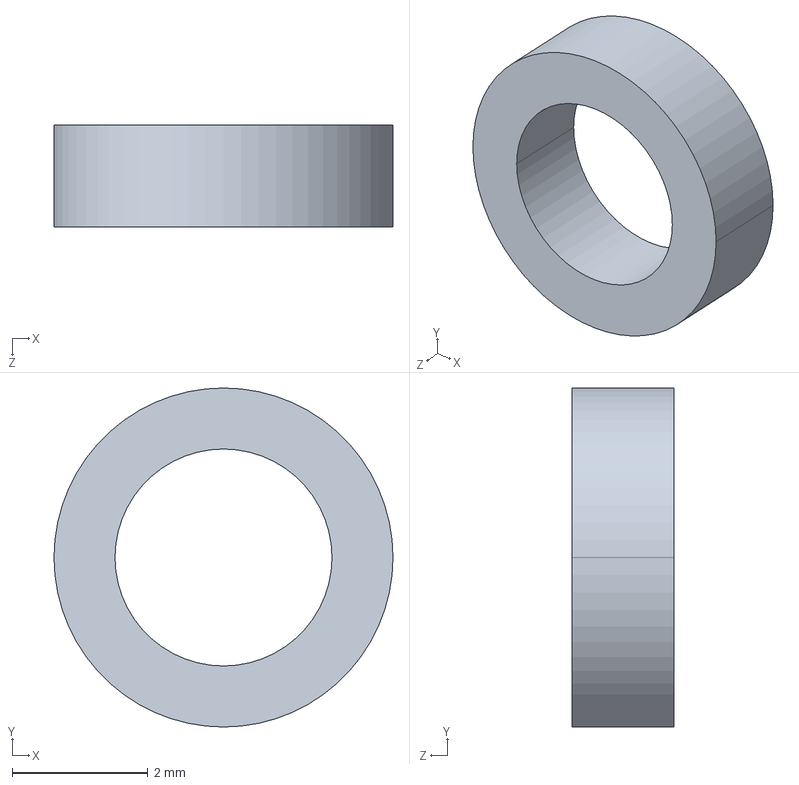
[picture p63: CAD file, 2026-11-02]
models/STEP/Parts/Preload_Rear_Spring_Spacer.step
5.00 x 5.00 x 1.50 mm
