psmithul/tensegrity-rover/models/STEP/Parts/Drive_Driven_Wheel_Axle.step

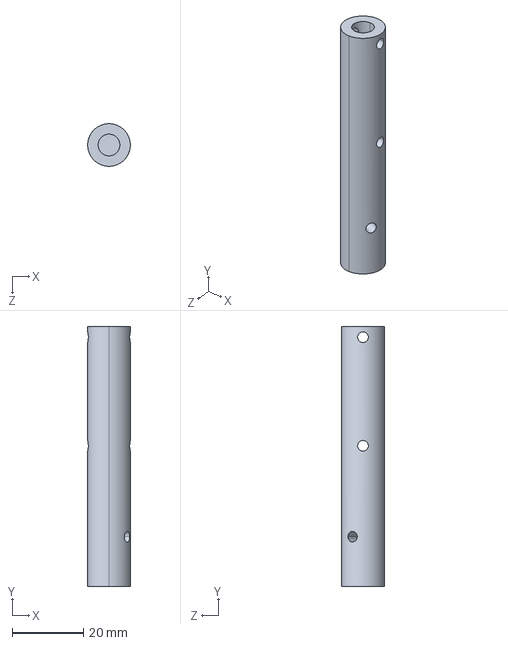
[picture p64: CAD file, 2026-11-02]
models/STEP/Parts/Drive_Driven_Wheel_Axle.step
12.0 x 73.0 x 12.0 mm
