psmithul/tensegrity-rover/models/STEP/Parts/Suspension_Compression_Link_3_Fixed_Ball_Retainer_Left.step

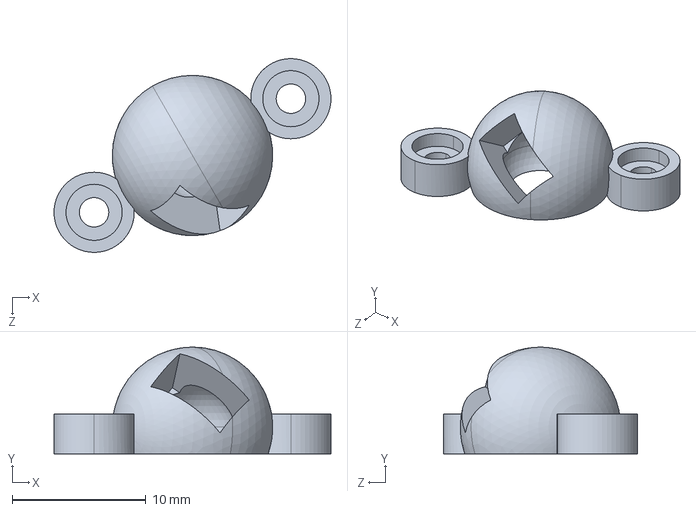
[picture p65: CAD file, 2026-11-02]
models/STEP/Parts/Suspension_Compression_Link_3_Fixed_Ball_Retainer_Left.step
20.7 x 8.00 x 14.5 mm
