psmithul/tensegrity-rover/models/STEP/Parts/Suspension_Encoder_Carrier_Bracket.step

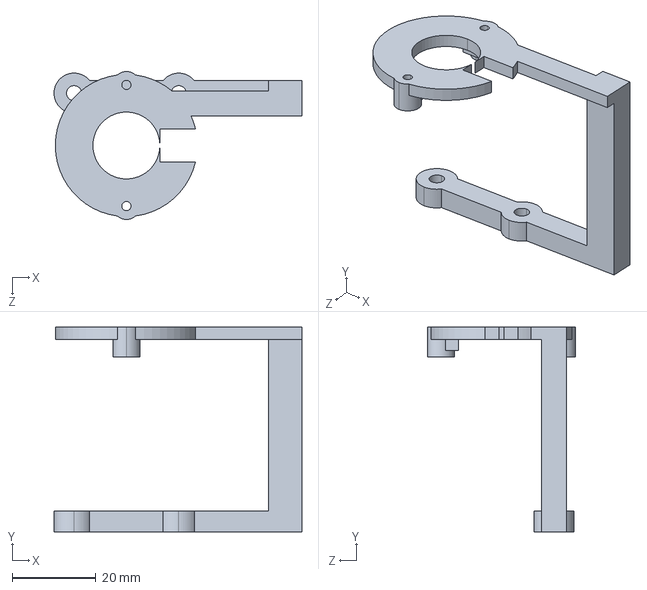
[picture p66: CAD file, 2026-11-02]
models/STEP/Parts/Suspension_Encoder_Carrier_Bracket.step
59.3 x 49.0 x 35.4 mm
