psmithul/tensegrity-rover/models/STEP/Parts/Suspension_Cable_Fairlead_Support_Frame.step

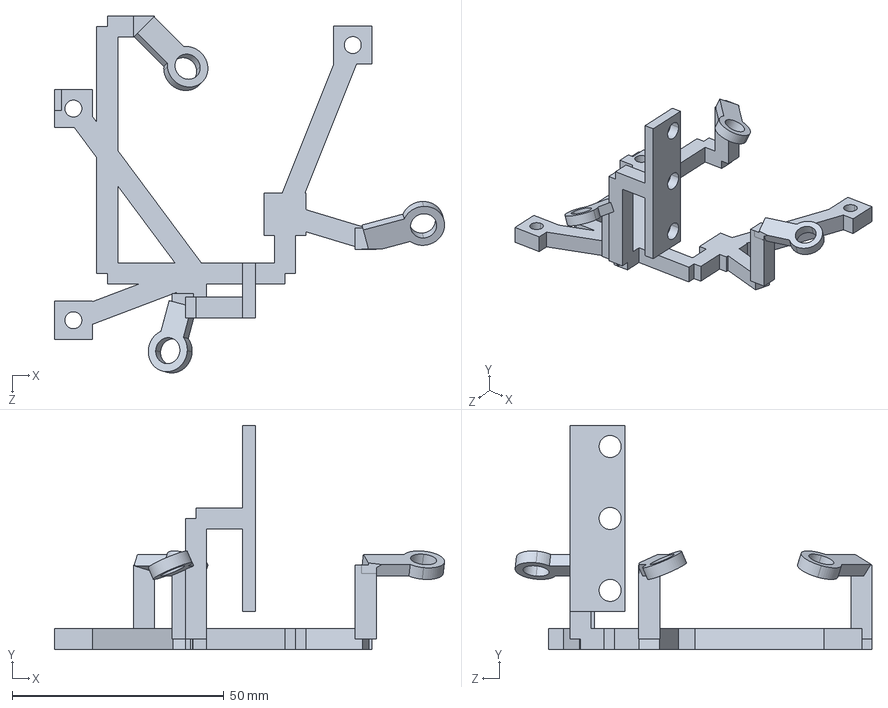
[picture p67: CAD file, 2026-11-02]
models/STEP/Parts/Suspension_Cable_Fairlead_Support_Frame.step
92.2 x 53.0 x 84.3 mm
