psmithul/tensegrity-rover/models/STEP/Parts/Suspension_Compression_Inner_Strut.step

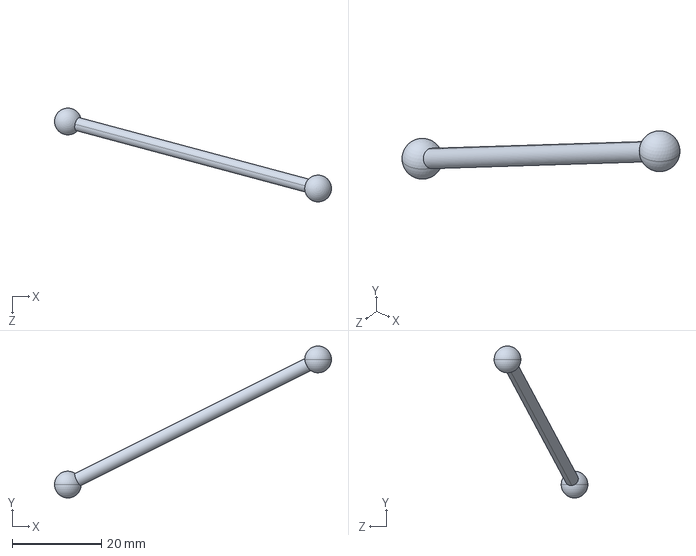
[picture p68: CAD file, 2026-11-02]
models/STEP/Parts/Suspension_Compression_Inner_Strut.step
62.0 x 34.0 x 21.0 mm
