psmithul/tensegrity-rover/models/STEP/Parts/Chassis_Platform_Segment_1.step

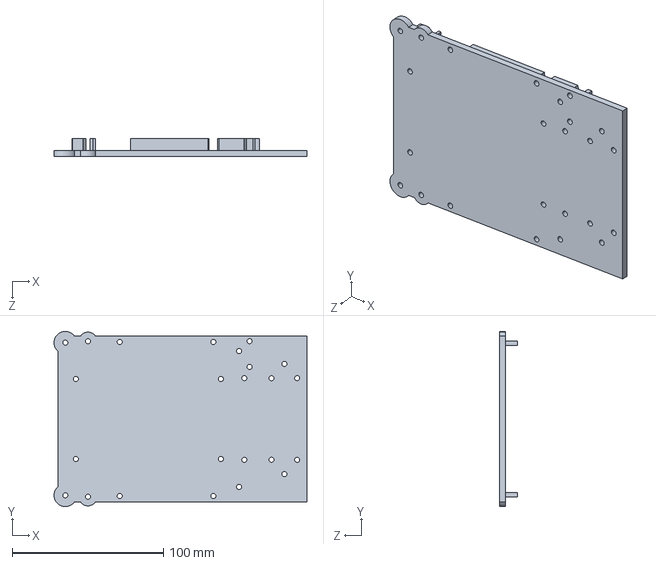
[picture p69: CAD file, 2026-11-02]
models/STEP/Parts/Chassis_Platform_Segment_1.step
167.5 x 116.0 x 12.0 mm
