psmithul/tensegrity-rover/models/STEP/Parts/Preload_Manual_Lock_Fork.step

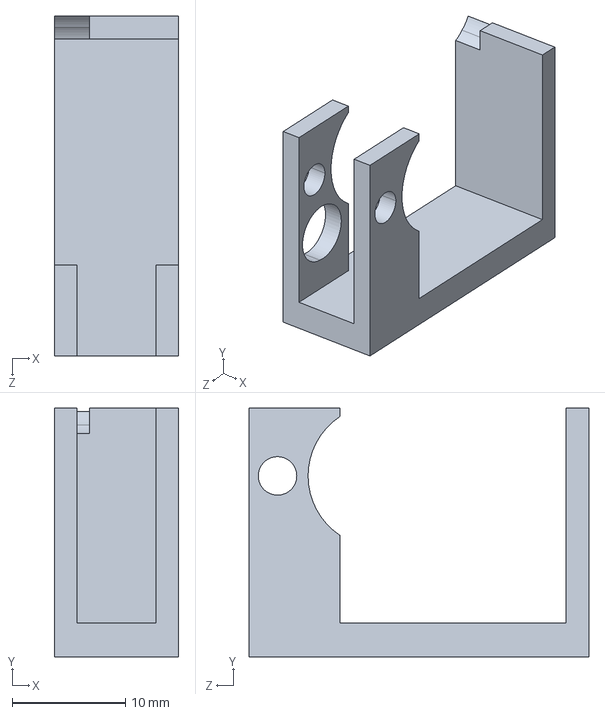
[picture p70: CAD file, 2026-11-02]
models/STEP/Parts/Preload_Manual_Lock_Fork.step
11.0 x 22.0 x 30.0 mm
