psmithul/tensegrity-rover/models/STEP/Parts/Suspension_Inlet_Fairlead_Liner_Left.step

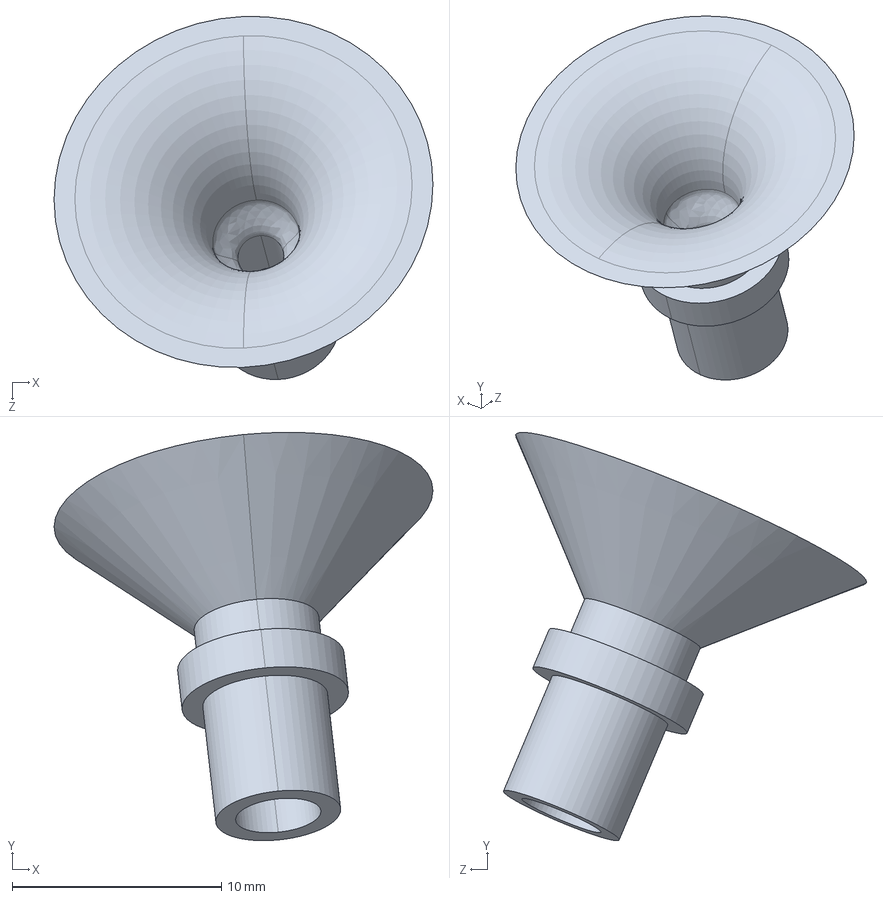
[picture p71: CAD file, 2026-11-02]
models/STEP/Parts/Suspension_Inlet_Fairlead_Liner_Left.step
18.1 x 19.5 x 17.3 mm
