psmithul/tensegrity-rover/models/STEP/Parts/Chassis_Relay_Mounting_Tray.step

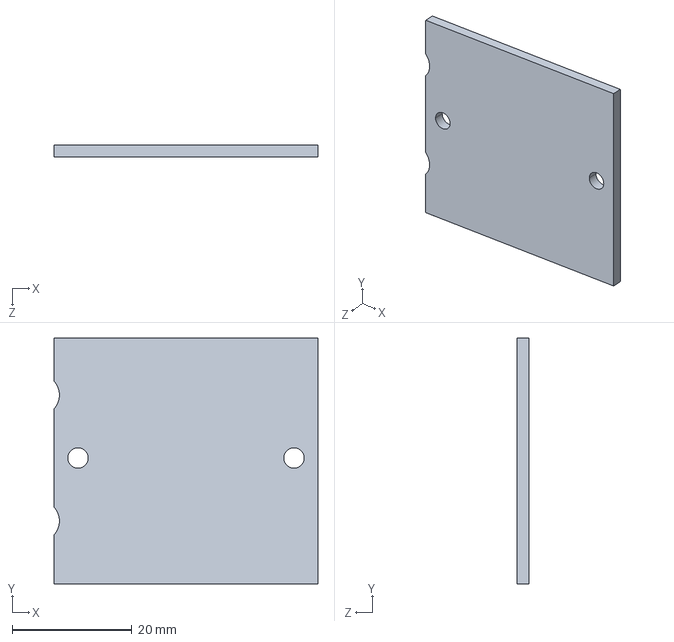
[picture p72: CAD file, 2026-11-02]
models/STEP/Parts/Chassis_Relay_Mounting_Tray.step
44.0 x 41.0 x 2.00 mm
