psmithul/tensegrity-rover/models/STEP/Parts/Suspension_Ribbed_TPU_Tyre.step

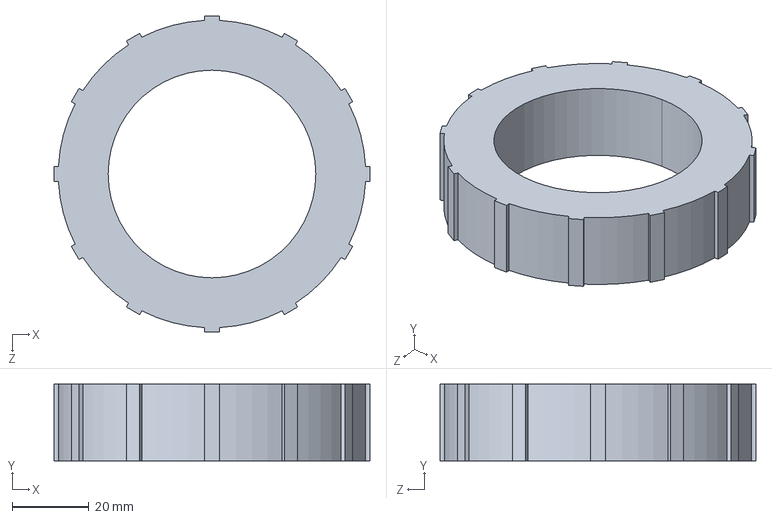
[picture p73: CAD file, 2026-11-02]
models/STEP/Parts/Suspension_Ribbed_TPU_Tyre.step
82.2 x 20.0 x 82.2 mm
