psmithul/tensegrity-rover/models/STEP/Parts/Suspension_Compression_Link_1_Moving_Ball_Retainer_Left.step

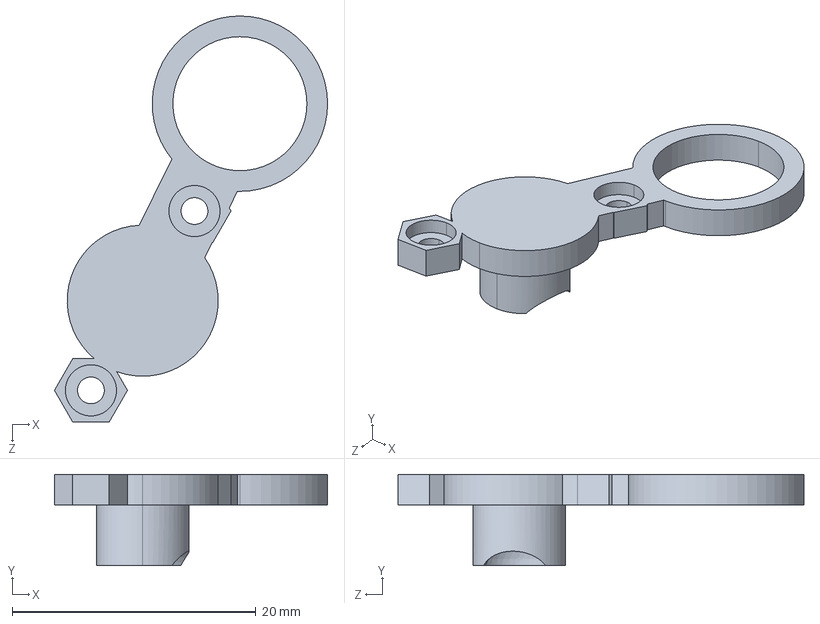
[picture p74: CAD file, 2026-11-02]
models/STEP/Parts/Suspension_Compression_Link_1_Moving_Ball_Retainer_Left.step
22.4 x 7.50 x 33.3 mm
