psmithul/tensegrity-rover/models/STEP/Parts/Drive_Bearing_Retaining_Cap.step

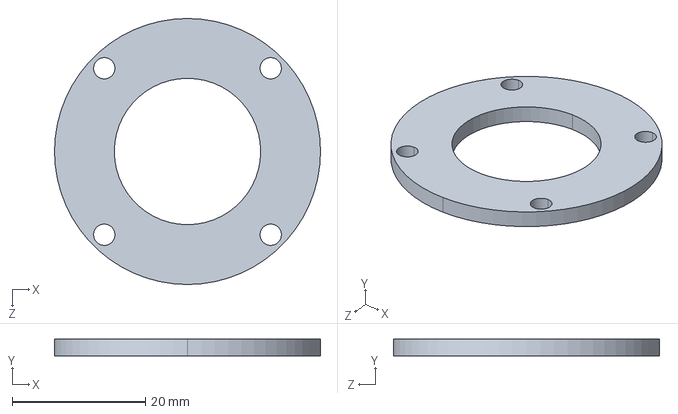
[picture p75: CAD file, 2026-11-02]
models/STEP/Parts/Drive_Bearing_Retaining_Cap.step
40.0 x 2.50 x 40.0 mm
