psmithul/tensegrity-rover/models/STEP/Parts/Chassis_Pico_Controller_Mount_1_Standoff.step

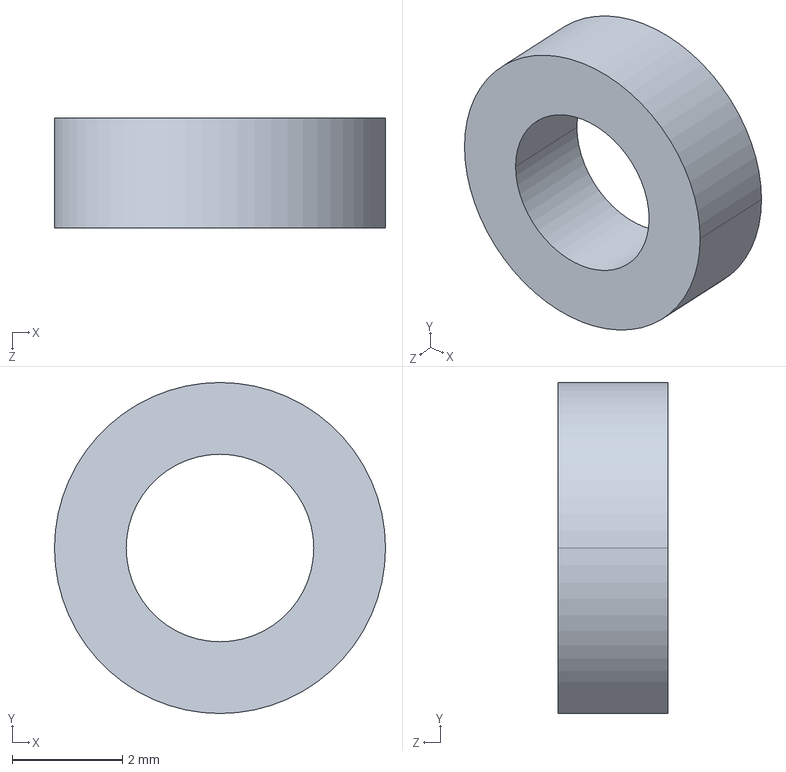
[picture p76: CAD file, 2026-11-02]
models/STEP/Parts/Chassis_Pico_Controller_Mount_1_Standoff.step
6.00 x 6.00 x 2.00 mm
