psmithul/tensegrity-rover/models/STEP/Parts/Suspension_Travel_Stop_Plate_Left.step

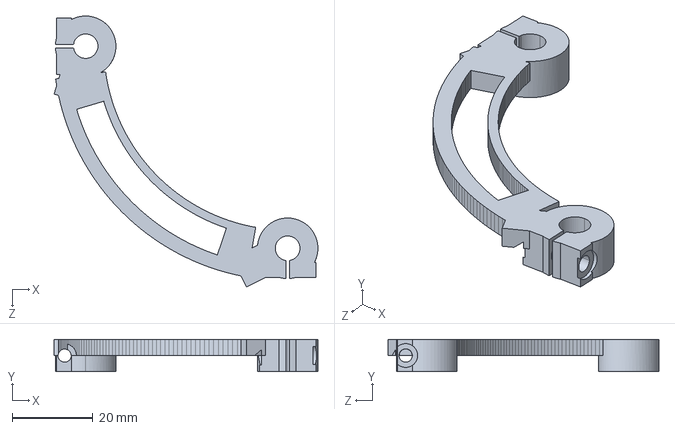
[picture p77: CAD file, 2026-11-02]
models/STEP/Parts/Suspension_Travel_Stop_Plate_Left.step
65.3 x 8.00 x 67.1 mm
