psmithul/tensegrity-rover/models/STEP/Parts/Chassis_Battery_Tray_Left.step

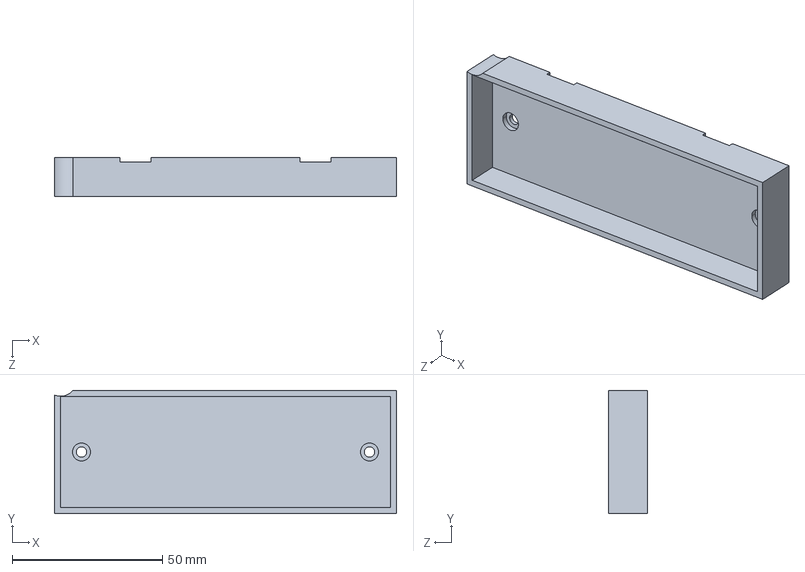
[picture p78: CAD file, 2026-11-02]
models/STEP/Parts/Chassis_Battery_Tray_Left.step
114.0 x 41.0 x 13.0 mm
