psmithul/tensegrity-rover/models/STEP/Parts/Frame_Spacer_Tube.step

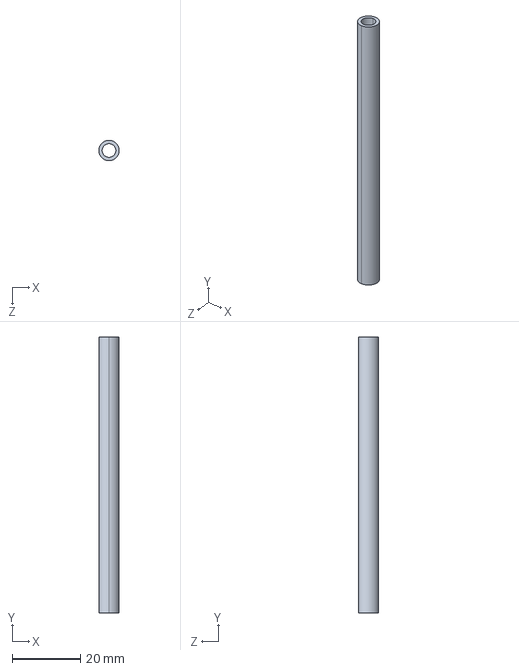
[picture p79: CAD file, 2026-11-02]
models/STEP/Parts/Frame_Spacer_Tube.step
6.00 x 81.0 x 6.00 mm
