psmithul/tensegrity-rover/models/STEP/Parts/Preload_Hard_Stop.step

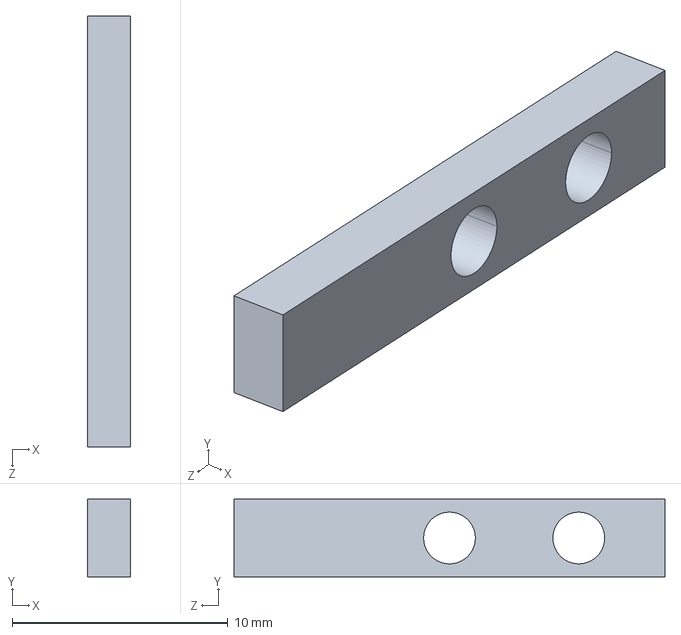
[picture p80: CAD file, 2026-11-02]
models/STEP/Parts/Preload_Hard_Stop.step
2.00 x 3.60 x 20.0 mm
