psmithul/tensegrity-rover/models/STEP/Parts/Frame_Tie_Stud.step

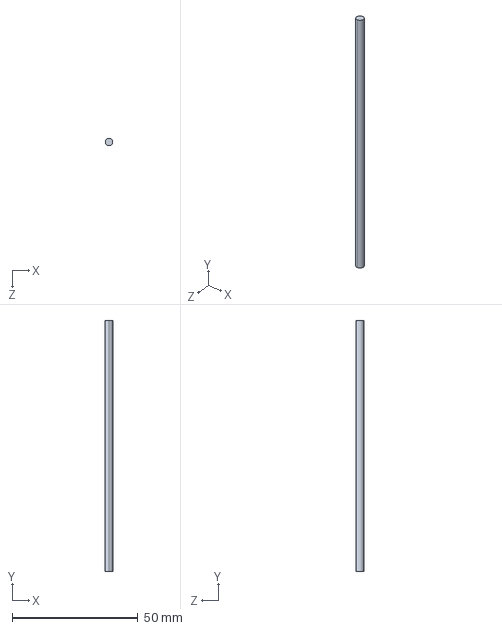
[picture p81: CAD file, 2026-11-02]
models/STEP/Parts/Frame_Tie_Stud.step
3.00 x 100.0 x 3.00 mm
