psmithul/tensegrity-rover/models/STEP/Parts/Preload_Coupling_and_Lock_Disc.step

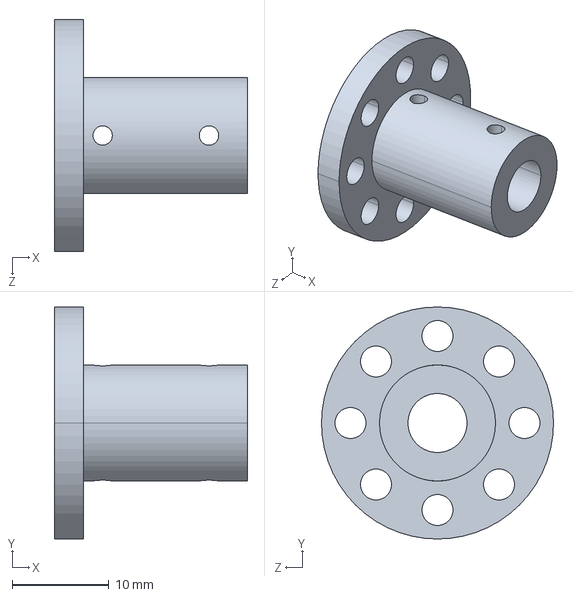
[picture p82: CAD file, 2026-11-02]
models/STEP/Parts/Preload_Coupling_and_Lock_Disc.step
20.0 x 24.0 x 24.0 mm
