psmithul/tensegrity-rover/models/STEP/Parts/Passive_Wheel_Carrier.step

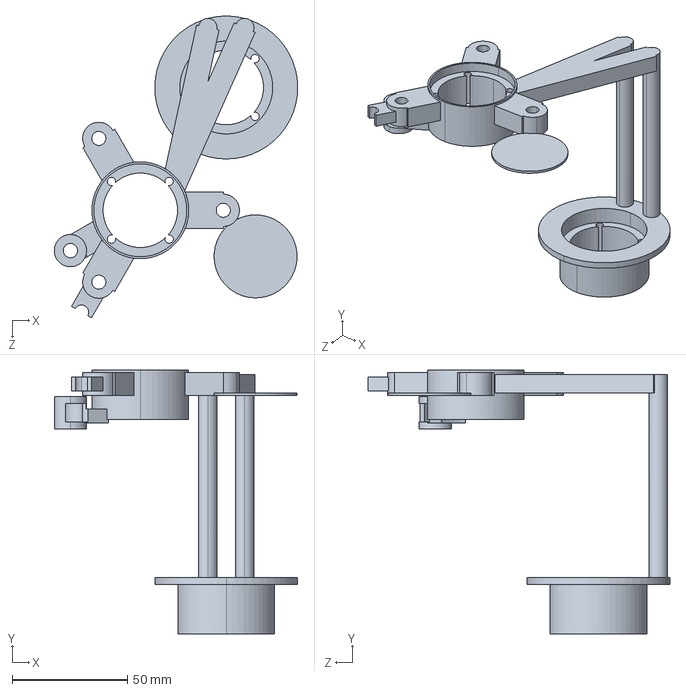
[picture p83: CAD file, 2026-11-02]
models/STEP/Parts/Passive_Wheel_Carrier.step
105.6 x 114.5 x 130.9 mm
