psmithul/tensegrity-rover/models/STEP/Parts/Suspension_Encoder_Shaft_Adapter.step

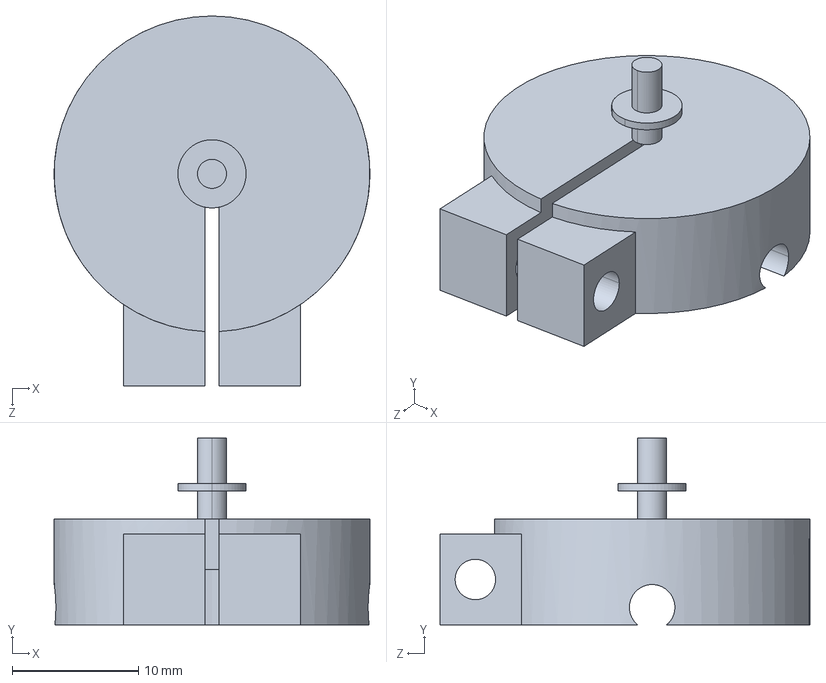
[picture p84: CAD file, 2026-11-02]
models/STEP/Parts/Suspension_Encoder_Shaft_Adapter.step
25.0 x 14.8 x 29.3 mm
