psmithul/tensegrity-rover/models/STEP/Parts/Chassis_Ballast_Retaining_Bar.step

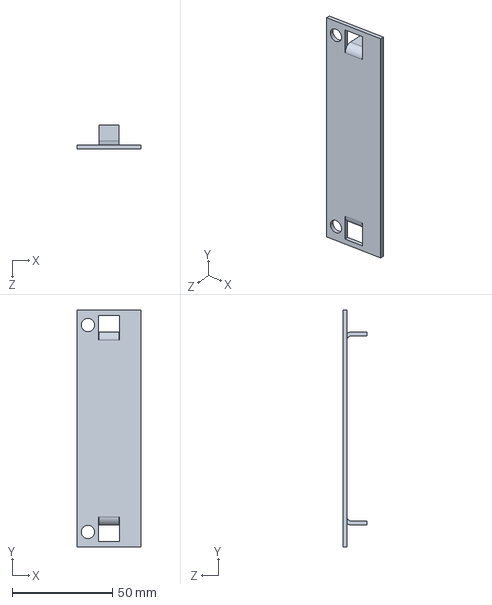
[picture p85: CAD file, 2026-11-02]
models/STEP/Parts/Chassis_Ballast_Retaining_Bar.step
32.0 x 118.0 x 12.0 mm
