psmithul/tensegrity-rover/models/STEP/Parts/Drive_Rear_Axle_Collar.step

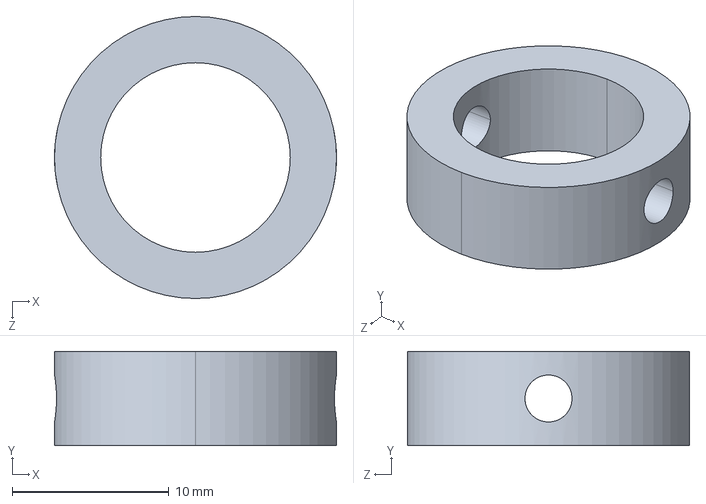
[picture p86: CAD file, 2026-11-02]
models/STEP/Parts/Drive_Rear_Axle_Collar.step
18.0 x 6.00 x 18.0 mm
