psmithul/tensegrity-rover/models/STEP/Parts/Driven_Wheel_Carrier_and_Motor_Mount_Left.step

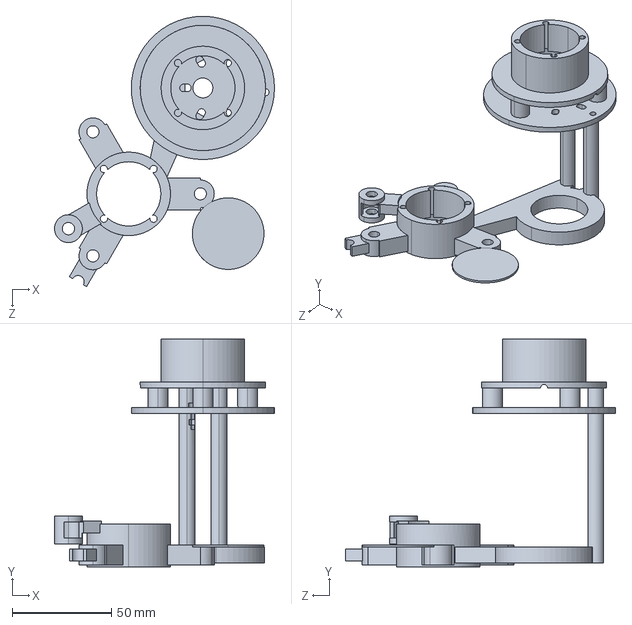
[picture p87: CAD file, 2026-11-02]
models/STEP/Parts/Driven_Wheel_Carrier_and_Motor_Mount_Left.step
110.6 x 114.5 x 135.9 mm
