psmithul/tensegrity-rover/models/STEP/Parts/Chassis_Roof_Support_Arm_2_Left.step

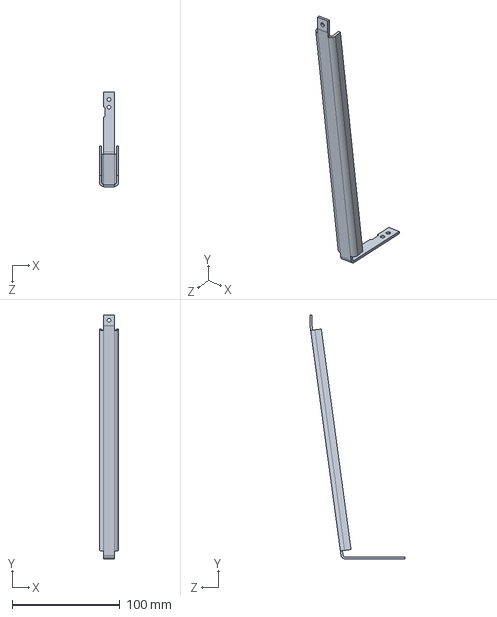
[picture p88: CAD file, 2026-11-02]
models/STEP/Parts/Chassis_Roof_Support_Arm_2_Left.step
18.0 x 226.0 x 88.0 mm
