psmithul/tensegrity-rover/models/STEP/Parts/Preload_Guide_Rod.step

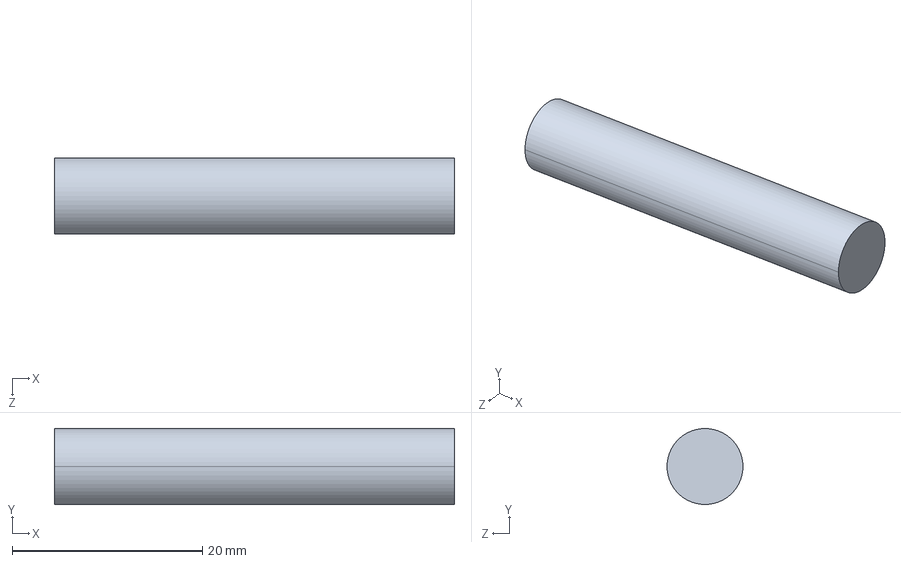
[picture p89: CAD file, 2026-11-02]
models/STEP/Parts/Preload_Guide_Rod.step
42.1 x 8.00 x 8.00 mm
