psmithul/tensegrity-rover/models/STEP/Parts/Suspension_Outlet_Housing_Reaction_Block.step

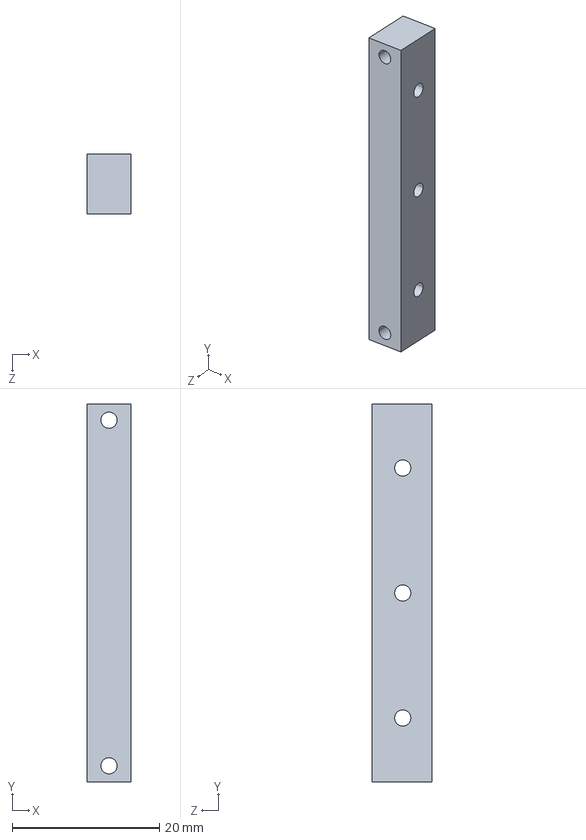
[picture p90: CAD file, 2026-11-02]
models/STEP/Parts/Suspension_Outlet_Housing_Reaction_Block.step
6.00 x 51.4 x 8.20 mm
