psmithul/tensegrity-rover/models/STEP/Parts/Preload_Metal_Thrust_Reaction_Plate.step

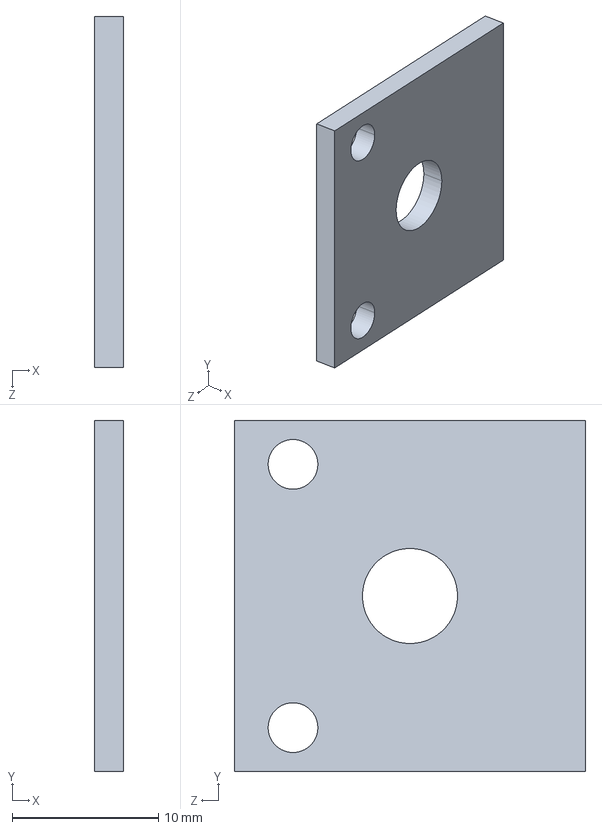
[picture p91: CAD file, 2026-11-02]
models/STEP/Parts/Preload_Metal_Thrust_Reaction_Plate.step
2.00 x 24.0 x 24.0 mm
