psmithul/tensegrity-rover/models/STEP/Parts/Chassis_Top_Cover_Panel_1.step

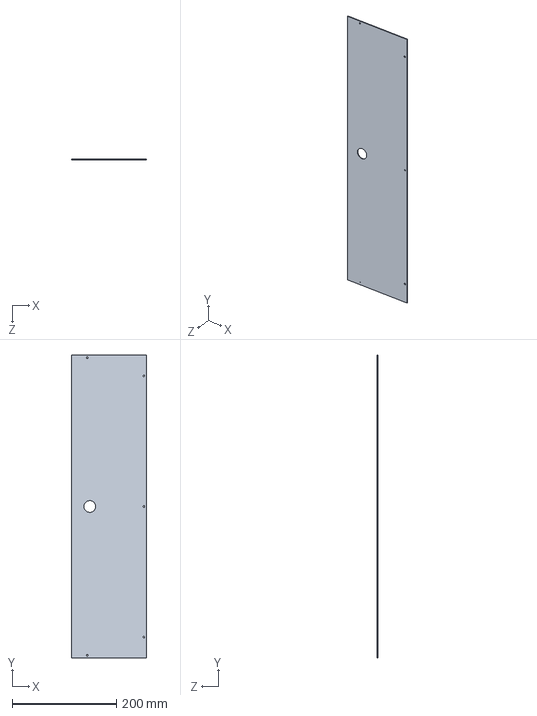
[picture p92: CAD file, 2026-11-02]
models/STEP/Parts/Chassis_Top_Cover_Panel_1.step
143.5 x 580.0 x 1.50 mm
