psmithul/tensegrity-rover/models/STEP/Parts/Chassis_Top_Cover_Panel_3.step

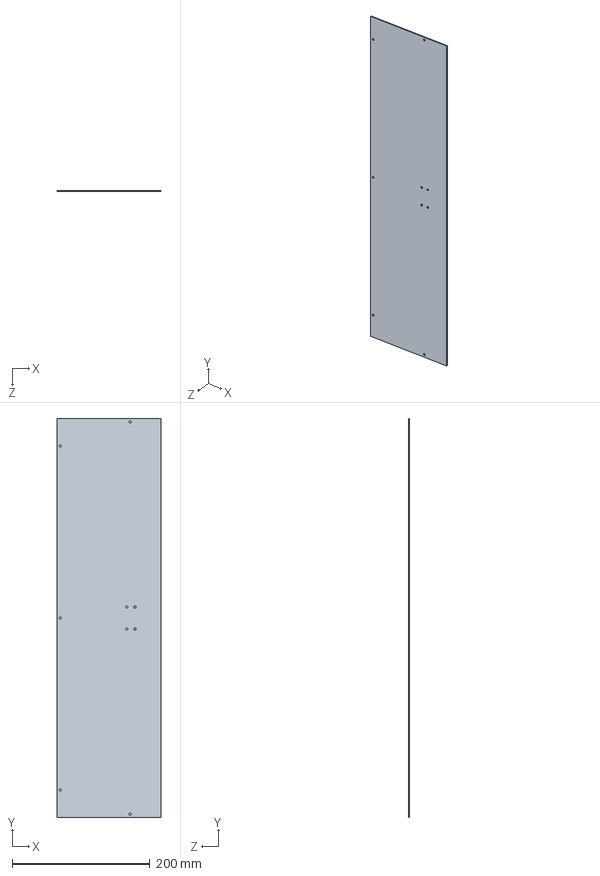
[picture p93: CAD file, 2026-11-02]
models/STEP/Parts/Chassis_Top_Cover_Panel_3.step
151.5 x 580.0 x 1.50 mm
