psmithul/tensegrity-rover/models/STEP/Parts/Drive_Front_Axle_Collar_Left.step

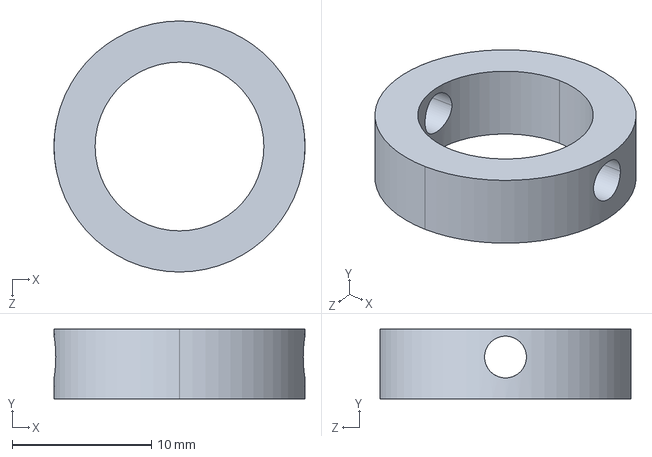
[picture p94: CAD file, 2026-11-02]
models/STEP/Parts/Drive_Front_Axle_Collar_Left.step
18.0 x 5.00 x 18.0 mm
