psmithul/tensegrity-rover/models/STEP/Parts/Chassis_Platform_Support_Column_1_Left.step

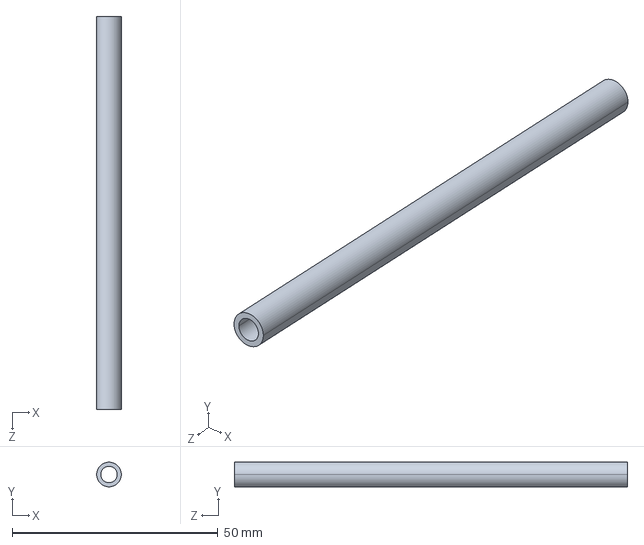
[picture p95: CAD file, 2026-11-02]
models/STEP/Parts/Chassis_Platform_Support_Column_1_Left.step
6.00 x 6.00 x 95.5 mm
