psmithul/tensegrity-rover/models/STEP/Parts/Suspension_Moving_Steel_Cup_Liner_1.step

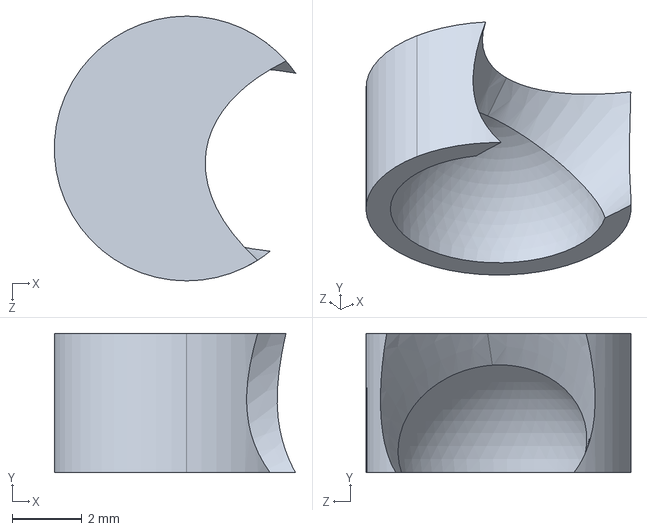
[picture p96: CAD file, 2026-11-02]
models/STEP/Parts/Suspension_Moving_Steel_Cup_Liner_1.step
6.92 x 4.00 x 7.60 mm
