psmithul/tensegrity-rover/models/STEP/Parts/Chassis_Power_Electronics_Shelf.step

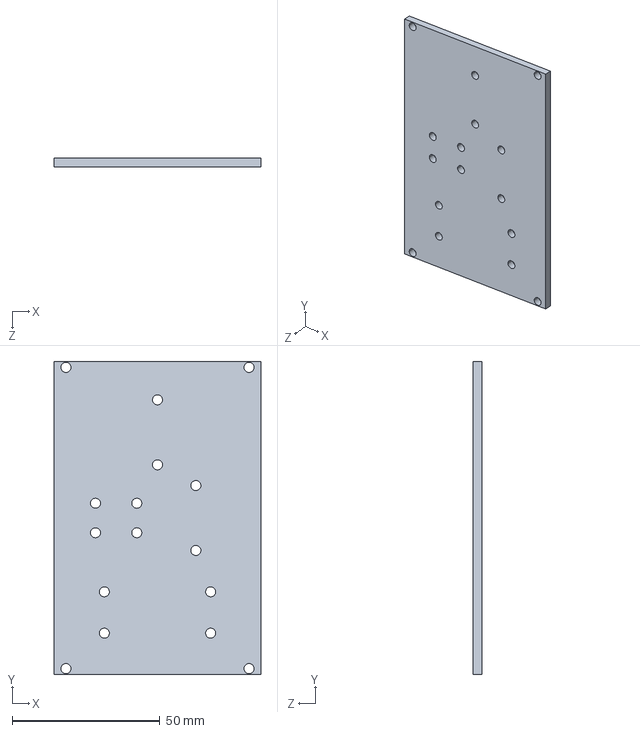
[picture p97: CAD file, 2026-11-02]
models/STEP/Parts/Chassis_Power_Electronics_Shelf.step
70.0 x 106.0 x 3.00 mm
