psmithul/tensegrity-rover/models/STEP/Parts/Chassis_Roof_Support_Arm_3_Right.step

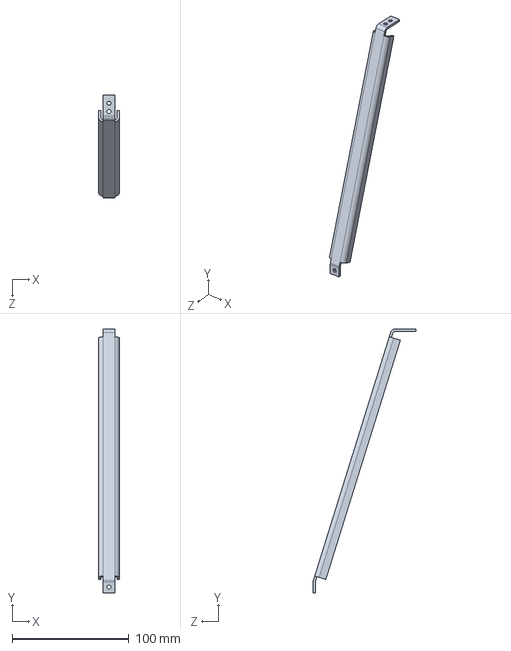
[picture p98: CAD file, 2026-11-02]
models/STEP/Parts/Chassis_Roof_Support_Arm_3_Right.step
18.0 x 226.0 x 88.0 mm
