psmithul/tensegrity-rover/models/STEP/Parts/Sensors_Accelerometer_Edge_Clamp.step

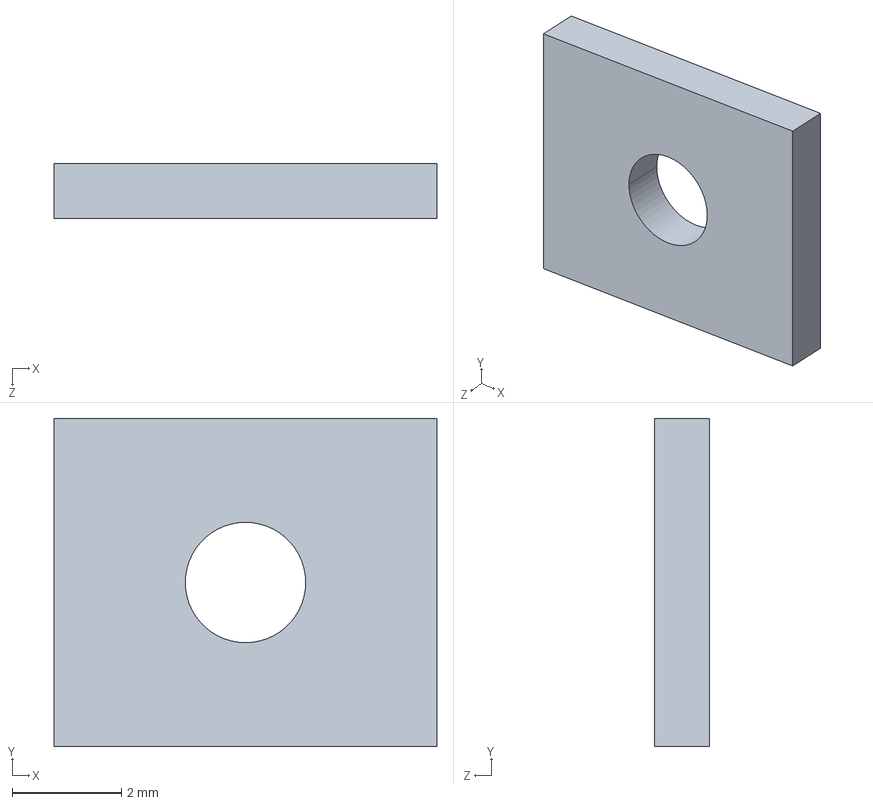
[picture p99: CAD file, 2026-11-02]
models/STEP/Parts/Sensors_Accelerometer_Edge_Clamp.step
7.00 x 6.00 x 1 mm
