psmithul/tensegrity-rover/models/STEP/Parts/Chassis_Battery_Connector_Clip.step

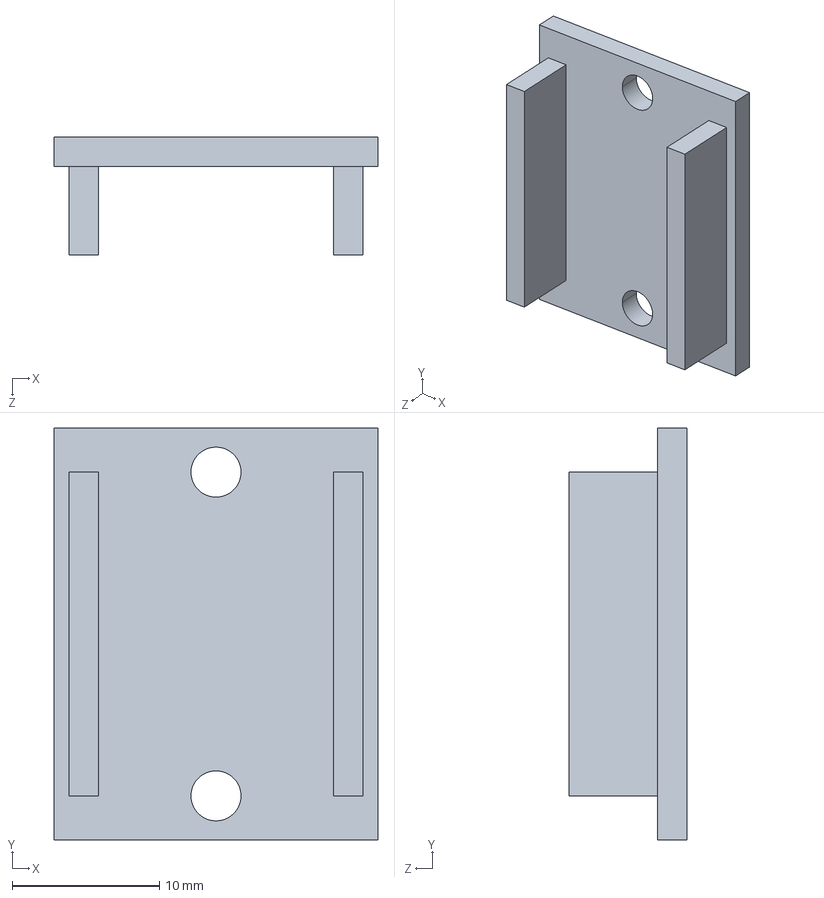
[picture p100: CAD file, 2026-11-02]
models/STEP/Parts/Chassis_Battery_Connector_Clip.step
22.0 x 28.0 x 8.00 mm
