psmithul/tensegrity-rover/models/STEP/Parts/Suspension_Travel_Stop_Pin.step

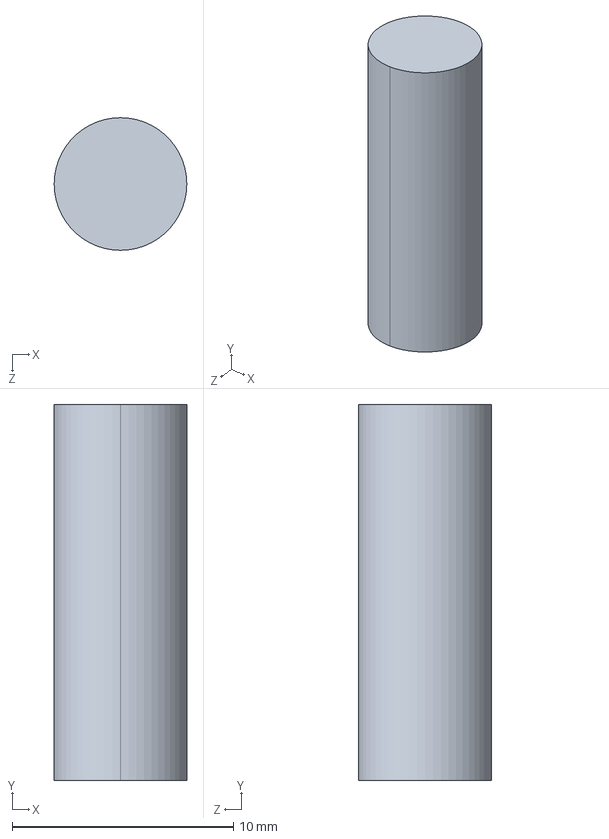
[picture p101: CAD file, 2026-11-02]
models/STEP/Parts/Suspension_Travel_Stop_Pin.step
6.00 x 17.0 x 6.00 mm
