psmithul/tensegrity-rover/models/STEP/Parts/Chassis_Battery_Strap_Right_1.step

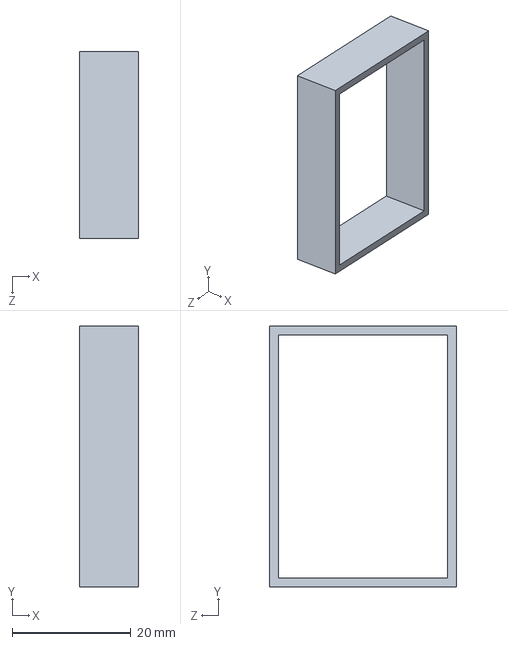
[picture p102: CAD file, 2026-11-02]
models/STEP/Parts/Chassis_Battery_Strap_Right_1.step
10.0 x 44.0 x 31.5 mm
