psmithul/tensegrity-rover/models/STEP/Parts/Suspension_Spring_Front_Grip_Acetal_Guide_Comb.step

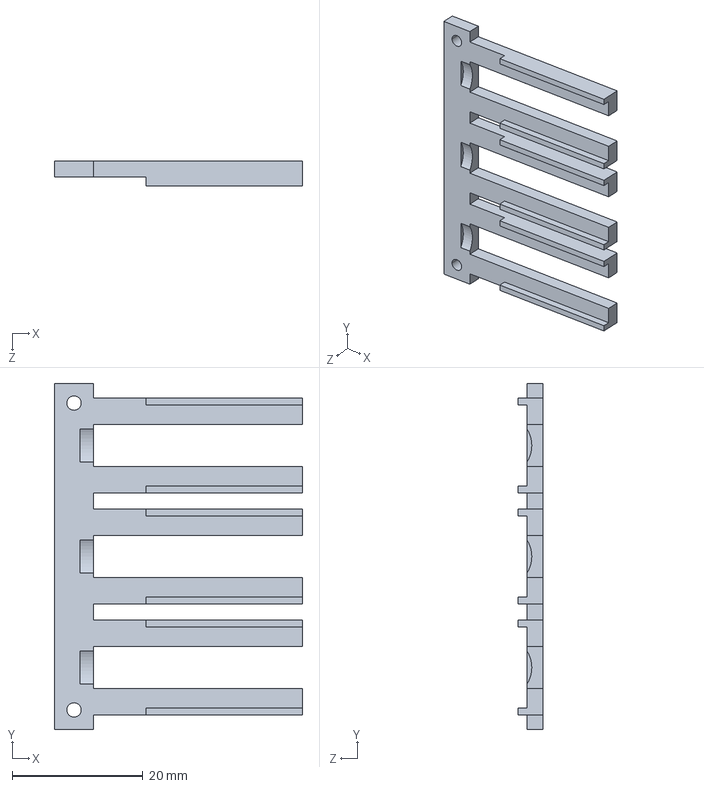
[picture p103: CAD file, 2026-11-02]
models/STEP/Parts/Suspension_Spring_Front_Grip_Acetal_Guide_Comb.step
38.0 x 53.0 x 3.90 mm
