psmithul/tensegrity-rover/models/STEP/Parts/Chassis_Platform_Segment_3.step

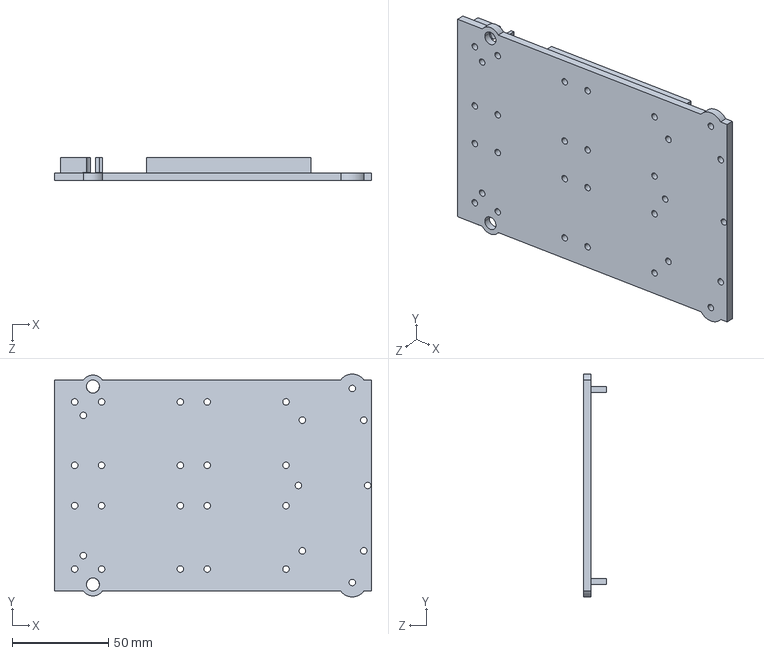
[picture p104: CAD file, 2026-11-02]
models/STEP/Parts/Chassis_Platform_Segment_3.step
165.0 x 116.0 x 12.0 mm
