psmithul/tensegrity-rover/models/STEP/Parts/Preload_Printed_Carriage_Left.step

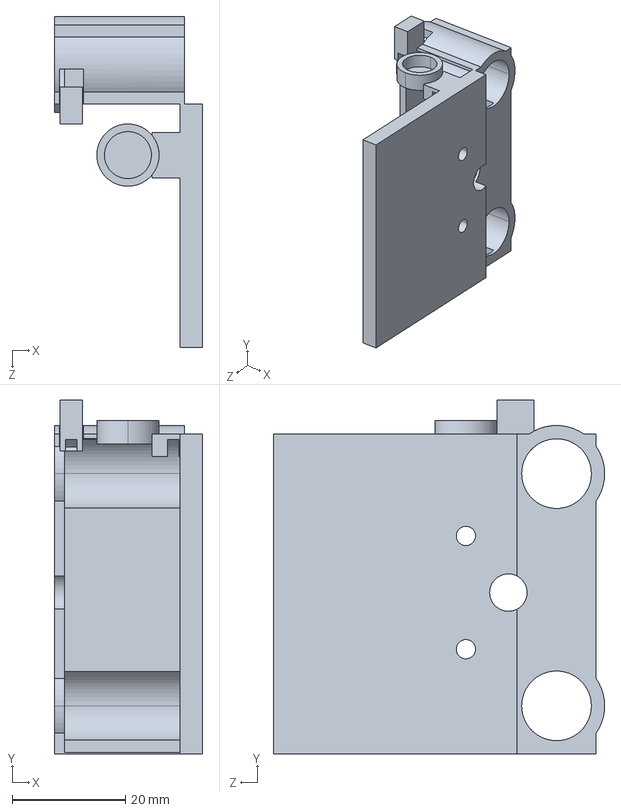
[picture p105: CAD file, 2026-11-02]
models/STEP/Parts/Preload_Printed_Carriage_Left.step
26.2 x 62.5 x 58.5 mm
