psmithul/tensegrity-rover/models/STEP/Parts/Chassis_Platform_Segment_2.step

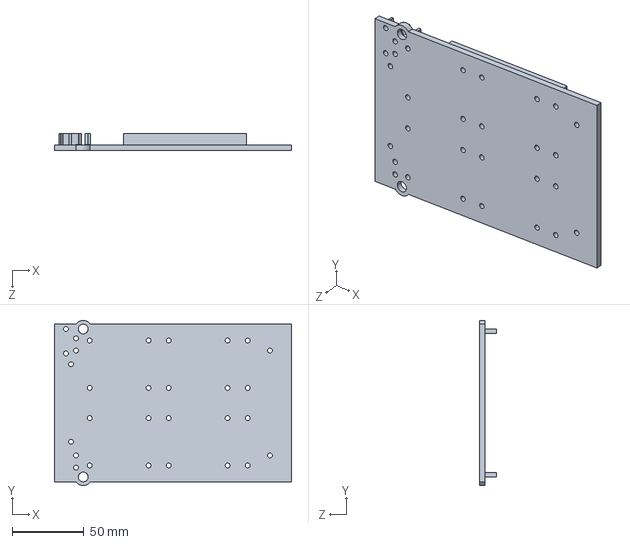
[picture p106: CAD file, 2026-11-02]
models/STEP/Parts/Chassis_Platform_Segment_2.step
165.0 x 115.0 x 12.0 mm
