psmithul/tensegrity-rover/models/SolidWorks/Assemblies/Vibration_Sensors.SLDASM

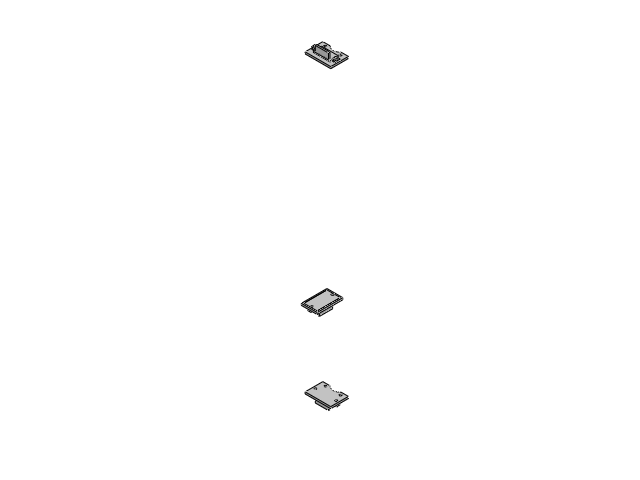
[picture p108: CAD file, 2026-11-02]
models/SolidWorks/Assemblies/Vibration_Sensors.SLDASM
Sensors_Chassis_Accelerometer_Mount
Sensors_Accelerometer_Edge_Clamp x 6
Sensors_Carrier_Accelerometer_Bracket x 2
Rover_Vibration_Sensors_References
