psmithul/tensegrity-rover/models/SolidWorks/Assemblies/Rear_Left_Suspension.SLDASM

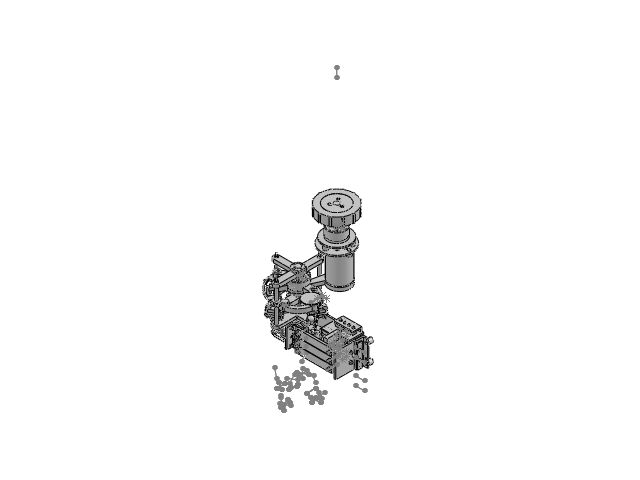
[picture p110: CAD file, 2026-11-02]
models/SolidWorks/Assemblies/Rear_Left_Suspension.SLDASM
Suspension_Cable_Anchor_Ball_Stud_Left x 3
Suspension_Cable_End_Ball_Socket_Left x 3
Fixed_Star_Plate_Left
DFM_Moving_Tensegrity_Frame_Left
Suspension_Suspension_Pivot_Shaft_Left
Suspension_Pivot_Shaft_Split_Clamp_Collar_Left
Suspension_Suspension_Travel_Stop_Plate_Left
Suspension_Suspension_Travel_Stop_Pin
Suspension_Compression_Inner_Strut_Left x 2
Suspension_Compression_Outer_Sleeve_Left x 3
DFM_Compression_Link_Torque_Pin_Left x 3
Suspension_Compression_Link_1_Fixed_Ball_Retainer_Left
Hardware_Retainer_Screw_ISO4762_M2x6_Left x 12
Suspension_Compression_Link_1_Moving_Ball_Retainer_Left
Suspension_Acetal_Torque_Guide_Bush_Locating_Left
Suspension_Compression_Inner_Strut_Lane2_Left
Suspension_Compression_Link_2_Fixed_Ball_Retainer_Left
Suspension_Compression_Link_2_Moving_Ball_Retainer_Left
Suspension_Acetal_Torque_Guide_Bush_Relieved_Left
Suspension_Compression_Link_3_Fixed_Ball_Retainer_Left
Suspension_Compression_Link_3_Moving_Ball_Retainer_Left
Suspension_Acetal_Torque_Guide_Bush_Floating_Left
Suspension_Front_Cable_Clevis x 3
Suspension_Spring_Flanged_Eyelet x 6
Suspension_Spring_Front_Grip_Acetal_Guide_Comb_Left
Suspension_Spring_Guide_Mount_M2_Screw_1 x 2
Suspension_Preload_Base_Mounting_Spacer x 4
Suspension_Inlet_Fairlead_Liner_Left x 3
Suspension_Outlet_Housing_Reaction_Block
Suspension_Cable_Fairlead_Support_Frame_Left
Suspension_Fixed_Steel_Cup_Liner_1_Left
Suspension_Fixed_Steel_Cup_Liner_2_Left
Suspension_Fixed_Steel_Cup_Liner_3_Left
Suspension_Moving_Steel_Cup_Liner_1_Left
Suspension_Moving_Steel_Cup_Liner_2_Left
Suspension_Moving_Steel_Cup_Liner_3_Left
Suspension_Cable_Support_Mounting_Spacer x 3
DFM_Driven_Wheel_Carrier_and_Motor_Mount_Left
Drive_Driven_Wheel_Axle_Left
Drive_Metal_Wheel_Hub_Left
Drive_Printed_Wheel_Rim_Left
Drive_Front_Wheel_Spacer x 2
Drive_Outer_Wheel_Spacer
Drive_Front_Axle_Collar_Left
Drive_Rear_Axle_Collar
Drive_Bearing_Cartridge_Left x 2
Drive_Bearing_Retaining_Cap x 2
Drive_Bearing_Outer_Race_Shim x 2
Drive_Removable_Drive_Motor_Guard_Left
Suspension_Pivot_Bearing_Inner_Spacer
Suspension_Front_Inner_Race_Locating_Sleeve
Suspension_Ribbed_TPU_Tyre
Preload_Preload_Motor_Output_Shaft
Preload_Preload_Screw_M6x1_RH
Preload_Preload_Coupling_and_Lock_Disc
Preload_Preload_Coupling_Cross_Pin x 2
Preload_Preload_Thrust_Bearing_F6_12M
Preload_Preload_Thrust_Washer
Preload_Preload_Thin_Locknut_M6
Preload_Preload_Metal_Thrust_Reaction_Plate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
