psmithul/tensegrity-rover/models/SolidWorks/Assemblies/Fixed_Frame.SLDASM

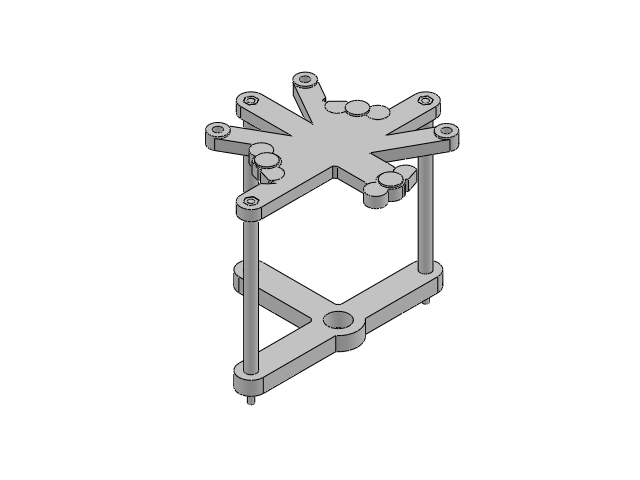
[picture p111: CAD file, 2026-11-02]
models/SolidWorks/Assemblies/Fixed_Frame.SLDASM
Fixed_Star_Plate
Rear_Support_Plate
Frame_Spacer_Tube x 3
Frame_Tie_Stud x 3
Frame_Tie_Nut x 6
Frame_Tie_Washer x 3
