psmithul/tensegrity-rover/models/SolidWorks/Assemblies/Chassis_and_Electronics.SLDASM

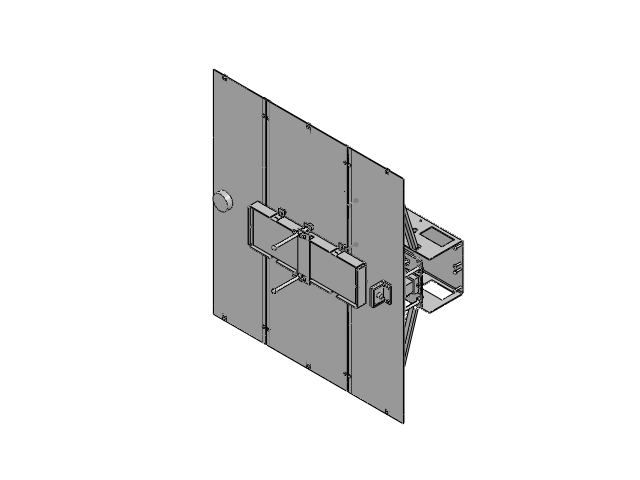
[picture p115: CAD file, 2026-11-02]
models/SolidWorks/Assemblies/Chassis_and_Electronics.SLDASM
Chassis_Bent_Aluminium_Chassis_Tray
Chassis_Platform_Segment_1
Chassis_Platform_Segment_2
Chassis_Platform_Segment_3
Chassis_Platform_Support_Column_1_Left x 6
Chassis_Platform_Joint_Strap_1_Left
Chassis_Platform_Joint_Strap_1_Right
Chassis_Platform_Joint_Strap_2_Left
Chassis_Platform_Joint_Strap_2_Right
Chassis_Battery_Tray_Right
Chassis_Battery_Strap_Right_1 x 4
Chassis_Battery_Tray_Left
Chassis_Controller_Shelf
Chassis_Controller_Shelf_Post_1 x 4
Chassis_Wheel_PWM_Board_PCA9685_Mount_1_Standoff x 60
Chassis_Pico_Controller_Mount_1_Standoff x 16
Chassis_Power_Electronics_Shelf
Chassis_Power_Shelf_Post_1 x 4
Chassis_Fuse_Holder_Clip
Chassis_Battery_Connector_Clip
Chassis_Relay_Mounting_Tray
Chassis_I2C_Interface_Shelf
Chassis_Limit_and_Lock_Expander_MCP23017_A_Mount_1_Standoff x 16
Chassis_Camera_Clip_Bracket
Chassis_Ballast_Support_Tube_2_Left x 4
Chassis_Ballast_Tray
Chassis_Example_Test_Weight_Plate_1 x 2
Chassis_Ballast_End_Stop_Rear
Chassis_Ballast_End_Stop_Front
Chassis_Ballast_Stud_Protective_Cap_51_5 x 2
Chassis_Ballast_Retaining_Bar
Chassis_Top_Cover_Panel_1
Chassis_Top_Cover_Panel_2
Chassis_Top_Cover_Panel_3
Chassis_Top_Cover_Joint_Strip_1
Chassis_Top_Cover_Joint_Strip_2
Chassis_Roof_Support_Arm_1_Left
Chassis_Roof_Support_Arm_1_Right
Chassis_Roof_Support_Arm_2_Left
Chassis_Roof_Support_Arm_2_Right
Chassis_Roof_Support_Arm_3_Left
Chassis_Roof_Support_Arm_3_Right
Rover_Chassis_and_Electronics_References
