psmithul/tensegrity-rover/(list of files, cad)

Other CAD files:
models/Complete_Rover.step
models/Suspension_Joint.step
models/SolidWorks/References/Rover_Vibration_Sensors_References.SLDPRT
models/Print_Blanks/Rear_Support_Plate_Print_Blank_Left.step
models/SolidWorks/References/Rover_Rear_Left_Suspension_References.SLDPRT
models/Print_Blanks/Fixed_Star_Plate_Print_Blank.step
models/STEP/Purchased_Components/Rover_Front_Left_Suspension_References.step
models/SolidWorks/References/Joint_Joint_Hardware_References.SLDPRT
models/SolidWorks/References/Rover_Front_Right_Suspension_References.SLDPRT
models/STEP/Purchased_Components/Rover_Rear_Right_Suspension_References.step
models/STEP/Purchased_Components/Rover_Front_Right_Suspension_References.step
models/SolidWorks/References/Rover_Front_Left_Suspension_References.SLDPRT
models/STEP/Purchased_Components/Joint_Wheel_and_Encoder_References.step
models/SolidWorks/References/Rover_Middle_Right_Suspension_References.SLDPRT
models/STEP/Purchased_Components/Joint_Sensor_References.step
models/SolidWorks/References/Rover_Rear_Right_Suspension_References.SLDPRT
models/STEP/Purchased_Components/Rover_Middle_Left_Suspension_References.step
models/SolidWorks/References/Joint_Tension_Network_References.SLDPRT
models/STEP/Purchased_Components/Rover_Chassis_and_Electronics_References.step
models/STEP/Parts/Chassis_Platform_Joint_Strap_2_Right.step
models/STEP/Parts/Suspension_Compression_Link_2_Moving_Ball_Retainer_Left.step
models/STEP/Parts/Compression_Link_Torque_Pin_Left.step
models/STEP/Parts/Preload_Guide_Rod_End_Stop_Left.step
models/STEP/Parts/Suspension_Cable_End_Ball_Socket.step
models/STEP/Parts/Rear_Support_Plate.step
models/STEP/Parts/Drive_Metal_Wheel_Hub_Left.step
models/STEP/Parts/Drive_Bearing_Cartridge.step
models/STEP/Parts/Suspension_Fixed_Steel_Cup_Liner_3.step
models/STEP/Parts/Drive_Printed_Wheel_Rim.step
models/STEP/Parts/Suspension_Cable_Fairlead_Support_Frame_Left.step
models/STEP/Parts/Suspension_Compression_Inner_Strut_Left.step
models/STEP/Parts/Drive_Removable_Drive_Motor_Guard_Left.step
models/STEP/Parts/Suspension_Cable_Anchor_Ball_Stud.step
models/STEP/Parts/Suspension_Compression_Link_2_Fixed_Ball_Retainer.step
models/STEP/Parts/Suspension_Fixed_Steel_Cup_Liner_2_Left.step
models/STEP/Parts/Suspension_Compression_Link_3_Fixed_Ball_Retainer.step
models/STEP/Parts/Preload_Manual_Lock_Pin.step
models/STEP/Parts/Suspension_Compression_Link_3_Moving_Ball_Retainer.step
models/STEP/Parts/Rear_Support_Plate_Left.step
models/STEP/Parts/Driven_Wheel_Carrier_and_Motor_Mount.step
models/STEP/Parts/Chassis_Platform_Joint_Strap_1_Left.step
models/STEP/Parts/Drive_Driven_Wheel_Axle_Left.step
models/STEP/Parts/Suspension_Compression_Link_1_Moving_Ball_Retainer.step
models/STEP/Parts/Suspension_Moving_Steel_Cup_Liner_2_Left.step
models/STEP/Parts/Suspension_Fixed_Steel_Cup_Liner_1_Left.step
models/STEP/Parts/Chassis_Roof_Support_Arm_1_Left.step
models/STEP/Parts/Chassis_Ballast_End_Stop_Front.step
models/STEP/Parts/Fixed_Star_Plate.step
models/Print_Blanks/Fixed_Star_Plate_Print_Blank.stl
models/Print_Blanks/Fixed_Star_Plate_Print_Blank_Left.stl
models/Print_Blanks/Rear_Support_Plate_Print_Blank.stl
models/Print_Blanks/Rear_Support_Plate_Print_Blank_Left.stl
models/STEP/Parts/Chassis_Ballast_Tray.step
models/STEP/Parts/Chassis_Battery_Tray_Right.step
models/STEP/Parts/Chassis_Bent_Aluminium_Chassis_Tray.step
models/STEP/Parts/Chassis_Camera_Clip_Bracket.step
models/STEP/Parts/Chassis_Controller_Shelf.step
models/STEP/Parts/Chassis_Controller_Shelf_Post_1.step
models/STEP/Parts/Chassis_Fuse_Holder_Clip.step
models/STEP/Parts/Chassis_Limit_and_Lock_Expander_MCP23017_A_Mount_1_Standoff.step
models/STEP/Parts/Chassis_Platform_Joint_Strap_2_Left.step
models/STEP/Parts/Chassis_Roof_Support_Arm_2_Right.step
models/STEP/Parts/Chassis_Roof_Support_Arm_3_Left.step
models/STEP/Parts/Chassis_Top_Cover_Joint_Strip_1.step
models/STEP/Parts/Chassis_Top_Cover_Panel_2.step
models/STEP/Parts/Chassis_Wheel_PWM_Board_PCA9685_Mount_1_Standoff.step
models/STEP/Parts/Drive_Bearing_Outer_Race_Shim.step
models/STEP/Parts/Drive_Front_Axle_Collar.step
models/STEP/Parts/Drive_Front_Wheel_Spacer.step
models/STEP/Parts/Drive_Outer_Wheel_Spacer.step
models/STEP/Parts/Drive_Passive_Wheel_Axle.step
models/STEP/Parts/Fixed_Star_Plate_Left.step
models/STEP/Parts/Frame_Spacer_Tube_Left.step
models/STEP/Parts/Frame_Tie_Nut.step
models/STEP/Parts/Frame_Tie_Nut_Left.step
models/STEP/Parts/Frame_Tie_Stud_Left.step
models/STEP/Parts/Frame_Tie_Washer.step
models/STEP/Parts/Frame_Tie_Washer_Left.step
models/STEP/Parts/Hardware_Retainer_Screw_ISO4762_M2x6.step
models/STEP/Parts/Hardware_Retainer_Screw_ISO4762_M2x6_Left.step
models/STEP/Parts/Moving_Tensegrity_Frame_Left.step
models/STEP/Parts/Passive_Wheel_Carrier_Left.step
models/STEP/Parts/Preload_Acetal_Guide_Bush.step
models/STEP/Parts/Preload_Carriage_Clamp_M3_Bolt.step
models/STEP/Parts/Preload_Carriage_Clamp_Washer.step
models/STEP/Parts/Preload_Carriage_Load_Washer.step
models/STEP/Parts/Preload_Coupling_Cross_Pin.step
models/STEP/Parts/Preload_Drive_Nut_M6.step
models/STEP/Parts/Preload_Guide_Stop_M3_Bolt.step
models/STEP/Parts/Preload_Manual_Lock_Fork_Left.step
models/STEP/Parts/Preload_Motor_Output_Shaft.step
models/STEP/Parts/Preload_Nut_Anti_Rotation_Clip.step
models/STEP/Parts/Preload_Printed_Base.step
models/STEP/Parts/Preload_Printed_Base_Left.step
models/STEP/Parts/Preload_Printed_Carriage.step
models/STEP/Parts/Preload_Rear_Spring_Shoulder_Bolt.step
models/STEP/Parts/Preload_Screw_M6x1_RH.step
models/STEP/Parts/Preload_Steel_Carriage_Core_Left.step
models/STEP/Parts/Preload_Thin_Locknut_M6.step
models/STEP/Parts/Preload_Thrust_Bearing_F6_12M.step
models/STEP/Parts/Preload_Thrust_Plate_M3_Bolt.step
models/STEP/Parts/Preload_Thrust_Plate_M3_Nut.step
models/STEP/Parts/Preload_Thrust_Washer.step
models/STEP/Parts/Sensors_Carrier_Accelerometer_Bracket.step
models/STEP/Parts/Suspension_Acetal_Torque_Guide_Bush_Floating.step
models/STEP/Parts/Suspension_Acetal_Torque_Guide_Bush_Floating_Left.step
models/STEP/Parts/Suspension_Acetal_Torque_Guide_Bush_Locating.step
models/STEP/Parts/Suspension_Acetal_Torque_Guide_Bush_Locating_Left.step
models/STEP/Parts/Suspension_Acetal_Torque_Guide_Bush_Relieved.step
models/STEP/Parts/Suspension_Compression_Inner_Strut_Lane2_Left.step
models/STEP/Parts/Suspension_Compression_Link_1_Fixed_Ball_Retainer.step
models/STEP/Parts/Suspension_Compression_Link_1_Fixed_Ball_Retainer_Left.step
models/STEP/Parts/Suspension_Compression_Link_2_Fixed_Ball_Retainer_Left.step
models/STEP/Parts/Suspension_Compression_Outer_Sleeve.step
models/STEP/Parts/Suspension_Encoder_Board_Edge_Clamp_1.step
models/STEP/Parts/Suspension_Encoder_Board_Edge_Clamp_2.step
models/STEP/Parts/Suspension_Fixed_Steel_Cup_Liner_1.step
models/STEP/Parts/Suspension_Fixed_Steel_Cup_Liner_3_Left.step
models/STEP/Parts/Suspension_Front_Inner_Race_Locating_Sleeve.step
models/STEP/Parts/Suspension_Inlet_Fairlead_Liner.step
models/STEP/Parts/Suspension_Moving_Steel_Cup_Liner_1_Left.step
models/STEP/Parts/Suspension_Moving_Steel_Cup_Liner_3.step
models/STEP/Parts/Suspension_Moving_Steel_Cup_Liner_3_Left.step
models/STEP/Parts/Suspension_Pivot_Bearing_Inner_Spacer.step
models/STEP/Parts/Suspension_Pivot_Shaft.step
models/STEP/Parts/Suspension_Pivot_Shaft_Left.step
models/STEP/Parts/Suspension_Pivot_Shaft_Split_Clamp_Collar.step
models/STEP/Parts/Suspension_Spring_Front_Grip_Acetal_Guide_Comb_Left.step
models/STEP/Parts/Suspension_Spring_Guide_Mount_M2_Screw_1.step
models/STEP/Parts/Suspension_Travel_Stop_Plate.step
models/STEP/Parts/Torque_Pin_M4_Flange_Nut.step
models/STEP/Parts/Torque_Pin_M4_Flange_Nut_Left.step
models/SolidWorks/Complete_Rover.SLDASM
models/SolidWorks/Parts/Chassis_Ballast_End_Stop_Front.SLDPRT
models/SolidWorks/Parts/Chassis_Ballast_End_Stop_Rear.SLDPRT
models/SolidWorks/Parts/Chassis_Ballast_Retaining_Bar.SLDPRT
models/SolidWorks/Parts/Chassis_Ballast_Stud_Protective_Cap_51_5.SLDPRT
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
