psmithul/tensegrity-rover/(commit log)

2026-10-01 Added fixed suspension frame
    [01_Fixed_Suspension_Frame.step]
2026-10-01 Added moving tensegrity frame
    [02_Moving_Tensegrity_Frame.step]
2026-10-03 Added suspension pivot shaft
    [03_Suspension_Pivot_Shaft.step]
2026-10-03 Added travel stop plate
    [04_Suspension_Travel_Stop_Plate.step]
2026-10-05 Added travel stop pin
    [05_Suspension_Travel_Stop_Pin.step]
2026-10-06 Added suspension pivot bearing
    [06_Suspension_Pivot_Bearing_1.step]
2026-10-07 Added inner compression strut
    [07_Compression_Link_1_Inner_Strut.step]
2026-10-07 Added compression link sleeve
    [08_Compression_Link_1_Outer_Sleeve.step]
2026-10-09 Added torque pin
    [09_Compression_Link_1_Torque_Pin.step]
2026-10-09 Added fixed ball retainer
    [10_Compression_Link_1_Fixed_Ball_Retainer.step]
2026-10-10 Added moving ball retainer
    [11_Compression_Link_1_Moving_Ball_Retainer.step]
2026-10-12 Added torque guide bushing
    [12_Compression_Link_1_Torque_Guide_Bushing.step]
2026-10-12 Added wheel hub and rim
    [13_Wheel_Hub_and_Rim.step]
2026-10-14 Added ribbed tire
    [14_Ribbed_Tire.step]
2026-10-14 Added wheel carrier
    [15_Wheel_Carrier.step]
2026-10-15 Added wheel support bearing
    [16_Wheel_Support_Bearing_1.step]
2026-10-17 Added bearing retaining cover
    [17_Wheel_Bearing_Retaining_Cover.step]
2026-10-17 Added preload motor bracket
    [18_Preload_Base_and_Motor_Bracket.step]
2026-10-18 Added preload gearmotor
    [19_Preload_Gearmotor.step]
2026-10-20 Added preload shaft coupling
    [20_Preload_Shaft_Coupling.step]
2026-10-20 Added preload thrust bearing
    [21_Preload_Screw_Thrust_Bearing.step]
2026-10-21 Added thrust bearing cover
    [22_Preload_Thrust_Bearing_Cover.step]
2026-10-22 Added preload guide rail
    [23_Preload_Carriage_Guide_Rail_1.step]
2026-10-22 Added spring preload carriage
    [24_Common_Spring_Preload_Carriage.step]
2026-10-23 Added M6 preload drive nut
    [25_Preload_M6_Fine_Thread_Drive_Nut.step]
2026-10-23 Added cable fairlead support
    [26_Cable_Fairlead_Support_Frame.step]
2026-10-24 Added elastomer spring
    [27_Elastomer_Spring_1.step]
2026-10-24 Added preload position sensor
    [28_Preload_Position_Hall_Sensor_Board.step]
2026-10-25 Added suspension assembly
    [Suspension_Joint.step]
2026-10-25 Added complete rover assembly
    [Complete_Rover.step]
2026-10-25 Updated slide text
    [CY06_Rover_BOM.xlsx]
2026-10-31 Fixed CAD solids
    [01_Fixed_Suspension_Frame.step, 02_Moving_Tensegrity_Frame.step, 10_Compression_Link_1_Fixed_Ball_Retainer.step, 11_Compression_Link_1_Moving_Ball_Retainer.step, 12_Compression_Link_1_Torque_Guide_Bushing.step, 22_Preload_Thrust_Bearing_Cover.step, 24_Common_Spring_Preload_Carriage.step, 26_Cable_Fairlead_Support_Frame.step]
2026-11-02 Updated rover review models
    [Complete_Rover_Review.step, Suspension_Joint_Review.step]
2026-11-02 Updated rover and suspension solids
    [Complete_Rover.step, Complete_Rover_Review.step, Suspension_Joint.step, Suspension_Joint_Review.step]
2026-11-02 Added editable rover parts
    [01_Fixed_Suspension_Frame.step, 02_Moving_Tensegrity_Frame.step, 03_Suspension_Pivot_Shaft.step, 04_Suspension_Travel_Stop_Plate.step, 05_Suspension_Travel_Stop_Pin.step, 06_Suspension_Pivot_Bearing_1.step, 07_Compression_Link_1_Inner_Strut.step, 08_Compression_Link_1_Outer_Sleeve.step]
2026-11-02 Added native rover assemblies
2026-11-02 Simplified frames and added editable parts
    [Accelerometer_Edge_Clamp.step, Acetal_Torque_Guide_Bush_Floating.step, Acetal_Torque_Guide_Bush_Floating_Left.step, Acetal_Torque_Guide_Bush_Locating.step, Acetal_Torque_Guide_Bush_Locating_Left.step, Acetal_Torque_Guide_Bush_Relieved.step, Acetal_Torque_Guide_Bush_Relieved_Left.step, Analog_Multiplexer1.step]
